Lone-Jade/ZYNQ7020-QR_Code_Recogition/skill/camera-hdmi-diagnosis/references/provenance.md

# Scope and verification limits

Camera source/control, pixel formats and geometry, memory transfer, processing and physical display diagnosis.

Configuration reads, refreshing counters and stored frame dumps establish different boundaries. Live frame integrity and physical output require observations from the actual system.

Use the checks appropriate to the requested change and report which were actually executed. Package contents are reusable procedures and helpers; they do not certify a new environment or target.
