Lone-Jade/ZYNQ7020-QR_Code_Recogition/src/hardware/pynq_ax7021b/hardware/desktop/README.md

# R4 HDMI硬件源文件

当前使用R4 PL彩色直显和绿色叠加。统一构建、启动和部署方式见项目根目录[README](../../../../../README.md)。本目录保留设计源文件，不提供旧桌面系统启动入口。
