Lone-Jade/ZYNQ7020-QR_Code_Recogition/src/hardware/pynq_ax7021b/hardware/qr_desktop/roi_selection/README.md

# R4 ROI 硬件源文件

保留实际使用的RTL和post-route脚本。统一构建入口见项目根README：build/scripts/hardware.py；旧A/B工具和PWM演示未进入最终包。
