Lone-Jade/ZYNQ7020-QR_Code_Recogition/skill/algorithm-porting-and-replay/references/provenance.md

# Scope and verification limits

Processing-code migration, numeric and semantic comparison, frozen-input regression and reproducible failure replay.

The supplied helpers inspect their documented input formats. Same-input equivalence does not qualify camera acquisition, physical I/O or target throughput.

Use the checks appropriate to the requested change and report which were actually executed. Package contents are reusable procedures and helpers; they do not certify a new environment or target.
