Lone-Jade/ZYNQ7020-QR_Code_Recogition/skill/hardware-build-and-handoff/references/provenance.md

# Scope and verification limits

Hardware-dependent build chains, interface matching, artifact qualification and reproducible delivery.

File hashes and metadata checks establish identity. Timing, ABI compatibility, boot success and runtime behavior require the corresponding tool or target checks.

Use the checks appropriate to the requested change and report which were actually executed. Package contents are reusable procedures and helpers; they do not certify a new environment or target.
