Lone-Jade/ZYNQ7020-QR_Code_Recogition/board/results/INTERFACES.md

# 运行与显示接口

PS 二维码公开结果结构为 8392 字节。`qr_mainline_get_symbol_geometry` 按最近一次成功结果的符号索引，返回解码源 epoch/frame、四个绝对坐标角点和对应 PL ROI。相同内容、不同空间位置的二维码保留独立发布身份。

显示 ABI 2 使用 ioctl D/5，结构大小 912 字节：16 字节头、128 字节 ASCII 状态区和 8 个 96 字节标注。显示驱动检查坐标、epoch、序号、标签和 pending 银行所有权。硬件 version=2、capabilities=11，场景能力位为 bit 8。

AXI-Lite `0x200..0x27c` 保存非活动场景描述符，`0x1000..0x13fc` 保存非活动字符 RAM。`0x20` 提交场景序号，`0x24` 返回确认。垂直消隐期同步切换框、标签与状态文字；pending 银行在确认前不可修改。连续 180 个输出帧无更新时图层过期。

PL 彩色预览独立于解码运行。停止识别会清除框和标签；完整停止由 `sudo zynq-qr stop` 管理。PS 最多显示 8 个目标，标签最多 9 个 ASCII 字符，并检查标签与所属框的相对位置、画面边界、状态区与其他标签的遮挡。

参考运行包仅显示来自成功解码的四角坐标，过期、乱序、epoch 不一致或关联不明确的标注会被隐藏。实际移动框覆盖率与摄像头到显示的延迟需通过明确的光学测试单独测量。
