Lone-Jade/ZYNQ7020-QR_Code_Recogition/build/reports/measured-final-v1/timing_summary.txt

Copyright 1986-2022 Xilinx, Inc. All Rights Reserved. Copyright 2022-2025 Advanced Micro Devices, Inc. All Rights Reserved.
-------------------------------------------------------------------------------------------------------------------------------------------------------------------------------
| Tool Version : Vivado v.2025.2 (lin64) Build 6299465 Fri Nov 14 12:34:56 MST 2025
| Date         : Sun Oct 25 19:09:49 2026
| Host         : build-host running 64-bit Ubuntu 22.04.5 LTS
| Command      : report_timing_summary -file /home/builder/FPGA_Competition/linux_bringup/development/C04-R4-FINALIZE/build/final-v1/ax7021b_linux_qr_desktop/timing_summary.txt
| Design       : qr_desktop_top
| Device       : 7z020-clg484
| Speed File   : -2  PRODUCTION 1.12 2019-11-22
| Design State : Routed
-------------------------------------------------------------------------------------------------------------------------------------------------------------------------------

Timing Summary Report

------------------------------------------------------------------------------------------------
| Timer Settings
| --------------
------------------------------------------------------------------------------------------------

  Enable Multi Corner Analysis               :  Yes
  Enable Pessimism Removal                   :  Yes
  Pessimism Removal Resolution               :  Nearest Common Node
  Enable Input Delay Default Clock           :  No
  Enable Preset / Clear Arcs                 :  No
  Disable Flight Delays                      :  No
  Ignore I/O Paths                           :  No
  Timing Early Launch at Borrowing Latches   :  No
  Borrow Time for Max Delay Exceptions       :  Yes
  Merge Timing Exceptions                    :  Yes
  Inter-SLR Compensation                     :  Conservative

  Corner  Analyze    Analyze    
  Name    Max Paths  Min Paths  
  ------  ---------  ---------  
  Slow    Yes        Yes        
  Fast    Yes        Yes        

------------------------------------------------------------------------------------------------
| Report Methodology
| ------------------
------------------------------------------------------------------------------------------------

Rule       Severity          Description                                                Violations  
---------  ----------------  ---------------------------------------------------------  ----------  
TIMING-4   Critical Warning  Invalid primary clock redefinition on a clock tree         1           
TIMING-27  Critical Warning  Invalid primary clock on hierarchical pin                  1           
LUTAR-1    Warning           LUT drives async reset alert                               8           
SYNTH-5    Warning           Mapped onto distributed RAM because of timing constraints  16          
SYNTH-6    Warning           Timing of a RAM block might be sub-optimal                 6           
TIMING-10  Warning           Missing property on synchronizer                           1           
TIMING-18  Warning           Missing input or output delay                              22          
ULMTCS-1   Warning           Control Sets use limits recommend reduction                1           
XDCB-5     Warning           Runtime inefficient way to find pin objects                1           

Note: This report is based on the most recent report_methodology run and may not be up-to-date. Run report_methodology on the current design for the latest report.

check_timing report

Table of Contents
-----------------
1. checking no_clock (0)
2. checking constant_clock (0)
3. checking pulse_width_clock (0)
4. checking unconstrained_internal_endpoints (0)
5. checking no_input_delay (14)
6. checking no_output_delay (7)
7. checking multiple_clock (0)
8. checking generated_clocks (0)
9. checking loops (0)
10. checking partial_input_delay (0)
11. checking partial_output_delay (0)
12. checking latch_loops (0)

1. checking no_clock (0)
------------------------
 There are 0 register/latch pins with no clock.

2. checking constant_clock (0)
------------------------------
 There are 0 register/latch pins with constant_clock.

3. checking pulse_width_clock (0)
---------------------------------
 There are 0 register/latch pins which need pulse_width check

4. checking unconstrained_internal_endpoints (0)
------------------------------------------------
 There are 0 pins that are not constrained for maximum delay.

 There are 0 pins that are not constrained for maximum delay due to constant clock.

5. checking no_input_delay (14)
-------------------------------
 There are 14 input ports with no input delay specified. (HIGH)

 There are 0 input ports with no input delay but user has a false path constraint.

6. checking no_output_delay (7)
-------------------------------
 There are 6 ports with no output delay specified. (HIGH)

 There are 0 ports with no output delay but user has a false path constraint

 There is 1 port with no output delay but with a timing clock defined on it or propagating through it (LOW)

7. checking multiple_clock (0)
------------------------------
 There are 0 register/latch pins with multiple clocks.

8. checking generated_clocks (0)
--------------------------------
 There are 0 generated clocks that are not connected to a clock source.

9. checking loops (0)
---------------------
 There are 0 combinational loops in the design.

10. checking partial_input_delay (0)
------------------------------------
 There are 0 input ports with partial input delay specified.

11. checking partial_output_delay (0)
-------------------------------------
 There are 0 ports with partial output delay specified.

12. checking latch_loops (0)
----------------------------
 There are 0 combinational latch loops in the design through latch input

------------------------------------------------------------------------------------------------
| Design Timing Summary
| ---------------------
------------------------------------------------------------------------------------------------

    WNS(ns)      TNS(ns)  TNS Failing Endpoints  TNS Total Endpoints      WHS(ns)      THS(ns)  THS Failing Endpoints  THS Total Endpoints     WPWS(ns)     TPWS(ns)  TPWS Failing Endpoints  TPWS Total Endpoints  
    -------      -------  ---------------------  -------------------      -------      -------  ---------------------  -------------------     --------     --------  ----------------------  --------------------  
      0.072        0.000                      0               142984        0.042        0.000                      0               142508        3.000        0.000                       0                 51697  

All user specified timing constraints are met.

------------------------------------------------------------------------------------------------
| Clock Summary
| -------------
------------------------------------------------------------------------------------------------

Clock                                       Waveform(ns)         Period(ns)      Frequency(MHz)
-----                                       ------------         ----------      --------------
cam1_pclk                                   {0.000 4.850}        9.700           103.093         
clk_fpga_0                                  {0.000 5.000}        10.000          100.000         
clk_fpga_1                                  {0.000 6.499}        12.999          76.929          
system_i/system_i/pixel_clock/inst/clk_in1  {0.000 5.000}        10.000          100.000         
  clk_out1_system_pixel_clock_0             {0.000 6.734}        13.468          74.250          
    hdmi_forwarded                          {6.734 13.468}       13.468          74.250          
  clkfbout_system_pixel_clock_0             {0.000 20.000}       40.000          25.000          

------------------------------------------------------------------------------------------------
| Intra Clock Table
| -----------------
------------------------------------------------------------------------------------------------

Clock                                           WNS(ns)      TNS(ns)  TNS Failing Endpoints  TNS Total Endpoints      WHS(ns)      THS(ns)  THS Failing Endpoints  THS Total Endpoints     WPWS(ns)     TPWS(ns)  TPWS Failing Endpoints  TPWS Total Endpoints  
-----                                           -------      -------  ---------------------  -------------------      -------      -------  ---------------------  -------------------     --------     --------  ----------------------  --------------------  
cam1_pclk                                         1.907        0.000                      0                 7091        0.076        0.000                      0                 7091        3.720        0.000                       0                  1461  
clk_fpga_0                                        0.401        0.000                      0                60391        0.042        0.000                      0                60391        3.870        0.000                       0                 28310  
clk_fpga_1                                        0.072        0.000                      0                72091        0.044        0.000                      0                72091        5.369        0.000                       0                 20877  
system_i/system_i/pixel_clock/inst/clk_in1                                                                                                                                                    3.000        0.000                       0                     1  
  clk_out1_system_pixel_clock_0                   2.126        0.000                      0                 2686        0.108        0.000                      0                 2686        5.880        0.000                       0                  1045  
  clkfbout_system_pixel_clock_0                                                                                                                                                              38.408        0.000                       0                     3  

------------------------------------------------------------------------------------------------
| Inter Clock Table
| -----------------
------------------------------------------------------------------------------------------------

From Clock                     To Clock                           WNS(ns)      TNS(ns)  TNS Failing Endpoints  TNS Total Endpoints      WHS(ns)      THS(ns)  THS Failing Endpoints  THS Total Endpoints  
----------                     --------                           -------      -------  ---------------------  -------------------      -------      -------  ---------------------  -------------------  
clk_fpga_0                     cam1_pclk                            7.871        0.000                      0                   40                                                                        
clk_fpga_1                     cam1_pclk                           11.714        0.000                      0                    5                                                                        
cam1_pclk                      clk_fpga_0                           6.760        0.000                      0                  219                                                                        
clk_fpga_1                     clk_fpga_0                          10.499        0.000                      0                   79                                                                        
clk_out1_system_pixel_clock_0  clk_fpga_0                           7.666        0.000                      0                  135                                                                        
cam1_pclk                      clk_fpga_1                           6.364        0.000                      0                   89                                                                        
clk_fpga_0                     clk_fpga_1                           8.691        0.000                      0                   73                                                                        
cam1_pclk                      clk_out1_system_pixel_clock_0        7.865        0.000                      0                    1                                                                        
clk_fpga_0                     clk_out1_system_pixel_clock_0        6.564        0.000                      0                  554                                                                        
clk_out1_system_pixel_clock_0  hdmi_forwarded                       0.405        0.000                      0                   27        6.184        0.000                      0                   27  

------------------------------------------------------------------------------------------------
| Other Path Groups Table
| -----------------------
------------------------------------------------------------------------------------------------

Path Group         From Clock         To Clock               WNS(ns)      TNS(ns)  TNS Failing Endpoints  TNS Total Endpoints      WHS(ns)      THS(ns)  THS Failing Endpoints  THS Total Endpoints  
----------         ----------         --------               -------      -------  ---------------------  -------------------      -------      -------  ---------------------  -------------------  
**async_default**  cam1_pclk          cam1_pclk                4.892        0.000                      0                   30        0.678        0.000                      0                   30  
**async_default**  clk_fpga_0         clk_fpga_0               5.903        0.000                      0                  192        0.598        0.000                      0                  192  

------------------------------------------------------------------------------------------------
| Timing Details
| --------------
------------------------------------------------------------------------------------------------

---------------------------------------------------------------------------------------------------
From Clock:  cam1_pclk
  To Clock:  cam1_pclk

Setup :            0  Failing Endpoints,  Worst Slack        1.907ns,  Total Violation        0.000ns
Hold  :            0  Failing Endpoints,  Worst Slack        0.076ns,  Total Violation        0.000ns
PW    :            0  Failing Endpoints,  Worst Slack        3.720ns,  Total Violation        0.000ns
---------------------------------------------------------------------------------------------------

Max Delay Paths
--------------------------------------------------------------------------------------
Slack (MET) :             1.907ns  (required time - arrival time)
  Source:                 capture_i/read_pointer_reg[1]_rep__1/C
                            (rising edge-triggered cell FDRE clocked by cam1_pclk  {rise@0.000ns fall@4.850ns period=9.700ns})
  Destination:            fork_i/display/memory_reg_0/ENARDEN
                            (rising edge-triggered cell RAMB36E1 clocked by cam1_pclk  {rise@0.000ns fall@4.850ns period=9.700ns})
  Path Group:             cam1_pclk
  Path Type:              Setup (Max at Slow Process Corner)
  Requirement:            9.700ns  (cam1_pclk rise@9.700ns - cam1_pclk rise@0.000ns)
  Data Path Delay:        7.145ns  (logic 1.733ns (24.255%)  route 5.412ns (75.745%))
  Logic Levels:           7  (LUT2=1 LUT3=1 LUT6=2 MUXF7=2 RAMD64E=1)
  Clock Path Skew:        -0.056ns (DCD - SCD + CPR)
    Destination Clock Delay (DCD):    4.691ns = ( 14.391 - 9.700 ) 
    Source Clock Delay      (SCD):    5.145ns
    Clock Pessimism Removal (CPR):    0.399ns
  Clock Uncertainty:      0.035ns  ((TSJ^2 + TIJ^2)^1/2 + DJ) / 2 + PE
    Total System Jitter     (TSJ):    0.071ns
    Total Input Jitter      (TIJ):    0.000ns
    Discrete Jitter          (DJ):    0.000ns
    Phase Error              (PE):    0.000ns

    Location             Delay type                Incr(ns)  Path(ns)    Netlist Resource(s)
  -------------------------------------------------------------------    -------------------
                         (clock cam1_pclk rise edge)
                                                      0.000     0.000 r  
    AB9                                               0.000     0.000 r  cam1_pclk (IN)
                         net (fo=0)                   0.000     0.000    cam1_pclk
    AB9                  IBUF (Prop_ibuf_I_O)         1.448     1.448 r  cam1_pclk_IBUF_inst/O
                         net (fo=1, routed)           2.207     3.655    cam1_pclk_IBUF
    BUFGCTRL_X0Y1        BUFG (Prop_bufg_I_O)         0.085     3.740 r  cam1_pclk_IBUF_BUFG_inst/O
                         net (fo=1460, routed)        1.405     5.145    capture_i/cam1_pclk_IBUF_BUFG
    SLICE_X45Y43         FDRE                                         r  capture_i/read_pointer_reg[1]_rep__1/C
  -------------------------------------------------------------------    -------------------
    SLICE_X45Y43         FDRE (Prop_fdre_C_Q)         0.379     5.524 r  capture_i/read_pointer_reg[1]_rep__1/Q
                         net (fo=85, routed)          1.136     6.660    capture_i/fifo_user_reg_768_895_0_0/DPRA1
    SLICE_X34Y40         RAMD64E (Prop_ramd64e_RADR1_O)
                                                      0.105     6.765 r  capture_i/fifo_user_reg_768_895_0_0/DP.HIGH/O
                         net (fo=1, routed)           0.000     6.765    capture_i/fifo_user_reg_768_895_0_0/DPO1
    SLICE_X34Y40         MUXF7 (Prop_muxf7_I1_O)      0.178     6.943 r  capture_i/fifo_user_reg_768_895_0_0/F7.DP/O
                         net (fo=1, routed)           0.760     7.703    capture_i/fifo_user_reg_768_895_0_0_n_0
    SLICE_X37Y42         LUT6 (Prop_lut6_I1_O)        0.241     7.944 r  capture_i/memory_reg_0_i_41/O
                         net (fo=1, routed)           0.000     7.944    capture_i/memory_reg_0_i_41_n_0
    SLICE_X37Y42         MUXF7 (Prop_muxf7_I1_O)      0.182     8.126 r  capture_i/memory_reg_0_i_16/O
                         net (fo=13, routed)          0.875     9.001    capture_i/capture_user
    SLICE_X43Y51         LUT2 (Prop_lut2_I0_O)        0.255     9.256 r  capture_i/system_i_i_2/O
                         net (fo=49, routed)          0.837    10.093    fork_i/display/diag_source_sof0
    SLICE_X48Y54         LUT6 (Prop_lut6_I5_O)        0.267    10.360 f  fork_i/display/memory_reg_0_i_36/O
                         net (fo=13, routed)          1.049    11.409    fork_i/display/memory_reg_0_i_36_n_0
    SLICE_X47Y49         LUT3 (Prop_lut3_I0_O)        0.126    11.535 r  fork_i/display/memory_reg_0_i_1/O
                         net (fo=2, routed)           0.756    12.290    fork_i/display/p_15_in
    RAMB36_X3Y9          RAMB36E1                                     r  fork_i/display/memory_reg_0/ENARDEN
  -------------------------------------------------------------------    -------------------

                         (clock cam1_pclk rise edge)
                                                      9.700     9.700 r  
    AB9                                               0.000     9.700 r  cam1_pclk (IN)
                         net (fo=0)                   0.000     9.700    cam1_pclk
    AB9                  IBUF (Prop_ibuf_I_O)         1.382    11.082 r  cam1_pclk_IBUF_inst/O
                         net (fo=1, routed)           1.894    12.976    cam1_pclk_IBUF
    BUFGCTRL_X0Y1        BUFG (Prop_bufg_I_O)         0.077    13.053 r  cam1_pclk_IBUF_BUFG_inst/O
                         net (fo=1460, routed)        1.337    14.391    fork_i/display/cam1_pclk_IBUF_BUFG
    RAMB36_X3Y9          RAMB36E1                                     r  fork_i/display/memory_reg_0/CLKARDCLK
                         clock pessimism              0.399    14.790    
                         clock uncertainty           -0.035    14.754    
    RAMB36_X3Y9          RAMB36E1 (Setup_ramb36e1_CLKARDCLK_ENARDEN)
                                                     -0.557    14.197    fork_i/display/memory_reg_0
  -------------------------------------------------------------------
                         required time                         14.197    
                         arrival time                         -12.290    
  -------------------------------------------------------------------
                         slack                                  1.907    

Min Delay Paths
--------------------------------------------------------------------------------------
Slack (MET) :             0.076ns  (arrival time - required time)
  Source:                 fork_i/display/wr_reg[5]/C
                            (rising edge-triggered cell FDRE clocked by cam1_pclk  {rise@0.000ns fall@4.850ns period=9.700ns})
  Destination:            fork_i/display/memory_reg_1/ADDRARDADDR[10]
                            (rising edge-triggered cell RAMB36E1 clocked by cam1_pclk  {rise@0.000ns fall@4.850ns period=9.700ns})
  Path Group:             cam1_pclk
  Path Type:              Hold (Min at Fast Process Corner)
  Requirement:            0.000ns  (cam1_pclk rise@0.000ns - cam1_pclk rise@0.000ns)
  Data Path Delay:        0.563ns  (logic 0.141ns (25.050%)  route 0.422ns (74.950%))
  Logic Levels:           0  
  Clock Path Skew:        0.304ns (DCD - SCD - CPR)
    Destination Clock Delay (DCD):    2.683ns
    Source Clock Delay      (SCD):    2.018ns
    Clock Pessimism Removal (CPR):    0.360ns

    Location             Delay type                Incr(ns)  Path(ns)    Netlist Resource(s)
  -------------------------------------------------------------------    -------------------
                         (clock cam1_pclk rise edge)
                                                      0.000     0.000 r  
    AB9                                               0.000     0.000 r  cam1_pclk (IN)
                         net (fo=0)                   0.000     0.000    cam1_pclk
    AB9                  IBUF (Prop_ibuf_I_O)         0.285     0.285 r  cam1_pclk_IBUF_inst/O
                         net (fo=1, routed)           1.126     1.411    cam1_pclk_IBUF
    BUFGCTRL_X0Y1        BUFG (Prop_bufg_I_O)         0.026     1.437 r  cam1_pclk_IBUF_BUFG_inst/O
                         net (fo=1460, routed)        0.582     2.018    fork_i/display/cam1_pclk_IBUF_BUFG
    SLICE_X56Y49         FDRE                                         r  fork_i/display/wr_reg[5]/C
  -------------------------------------------------------------------    -------------------
    SLICE_X56Y49         FDRE (Prop_fdre_C_Q)         0.141     2.159 r  fork_i/display/wr_reg[5]/Q
                         net (fo=5, routed)           0.422     2.581    fork_i/display/wr_reg[5]
    RAMB36_X3Y10         RAMB36E1                                     r  fork_i/display/memory_reg_1/ADDRARDADDR[10]
  -------------------------------------------------------------------    -------------------

                         (clock cam1_pclk rise edge)
                                                      0.000     0.000 r  
    AB9                                               0.000     0.000 r  cam1_pclk (IN)
                         net (fo=0)                   0.000     0.000    cam1_pclk
    AB9                  IBUF (Prop_ibuf_I_O)         0.473     0.473 r  cam1_pclk_IBUF_inst/O
                         net (fo=1, routed)           1.295     1.768    cam1_pclk_IBUF
    BUFGCTRL_X0Y1        BUFG (Prop_bufg_I_O)         0.029     1.797 r  cam1_pclk_IBUF_BUFG_inst/O
                         net (fo=1460, routed)        0.886     2.683    fork_i/display/cam1_pclk_IBUF_BUFG
    RAMB36_X3Y10         RAMB36E1                                     r  fork_i/display/memory_reg_1/CLKARDCLK
                         clock pessimism             -0.360     2.323    
    RAMB36_X3Y10         RAMB36E1 (Hold_ramb36e1_CLKARDCLK_ADDRARDADDR[10])
                                                      0.183     2.506    fork_i/display/memory_reg_1
  -------------------------------------------------------------------
                         required time                         -2.506    
                         arrival time                           2.581    
  -------------------------------------------------------------------
                         slack                                  0.076    

Pulse Width Checks
--------------------------------------------------------------------------------------
Clock Name:         cam1_pclk
Waveform(ns):       { 0.000 4.850 }
Period(ns):         9.700
Sources:            { cam1_pclk }

Check Type        Corner  Lib Pin             Reference Pin  Required(ns)  Actual(ns)  Slack(ns)  Location      Pin
Min Period        n/a     RAMB36E1/CLKARDCLK  n/a            2.472         9.700       7.228      RAMB36_X3Y9   fork_i/display/memory_reg_0/CLKARDCLK
Low Pulse Width   Slow    RAMD64E/CLK         n/a            1.130         4.850       3.720      SLICE_X58Y49  capture_i/fifo_data_reg_0_63_0_2/RAMA/CLK
High Pulse Width  Slow    RAMD64E/CLK         n/a            1.130         4.850       3.720      SLICE_X58Y49  capture_i/fifo_data_reg_0_63_0_2/RAMA/CLK

---------------------------------------------------------------------------------------------------
From Clock:  clk_fpga_0
  To Clock:  clk_fpga_0

Setup :            0  Failing Endpoints,  Worst Slack        0.401ns,  Total Violation        0.000ns
Hold  :            0  Failing Endpoints,  Worst Slack        0.042ns,  Total Violation        0.000ns
PW    :            0  Failing Endpoints,  Worst Slack        3.870ns,  Total Violation        0.000ns
---------------------------------------------------------------------------------------------------

Max Delay Paths
--------------------------------------------------------------------------------------
Slack (MET) :             0.401ns  (required time - arrival time)
  Source:                 system_i/system_i/ps7/inst/PS7_i/MAXIGP0ACLK
                            (rising edge-triggered cell PS7 clocked by clk_fpga_0  {rise@0.000ns fall@5.000ns period=10.000ns})
  Destination:            system_i/system_i/display_osd/inst/wstrb_reg[3]/D
                            (rising edge-triggered cell FDRE clocked by clk_fpga_0  {rise@0.000ns fall@5.000ns period=10.000ns})
  Path Group:             clk_fpga_0
  Path Type:              Setup (Max at Slow Process Corner)
  Requirement:            10.000ns  (clk_fpga_0 rise@10.000ns - clk_fpga_0 rise@0.000ns)
  Data Path Delay:        9.206ns  (logic 1.108ns (12.036%)  route 8.098ns (87.964%))
  Logic Levels:           0  
  Clock Path Skew:        -0.212ns (DCD - SCD + CPR)
    Destination Clock Delay (DCD):    2.234ns = ( 12.234 - 10.000 ) 
    Source Clock Delay      (SCD):    2.542ns
    Clock Pessimism Removal (CPR):    0.097ns
  Clock Uncertainty:      0.154ns  ((TSJ^2 + TIJ^2)^1/2 + DJ) / 2 + PE
    Total System Jitter     (TSJ):    0.071ns
    Total Input Jitter      (TIJ):    0.300ns
    Discrete Jitter          (DJ):    0.000ns
    Phase Error              (PE):    0.000ns

    Location             Delay type                Incr(ns)  Path(ns)    Netlist Resource(s)
  -------------------------------------------------------------------    -------------------
                         (clock clk_fpga_0 rise edge)
                                                      0.000     0.000 r  
    PS7_X0Y0             PS7                          0.000     0.000 r  system_i/system_i/ps7/inst/PS7_i/FCLKCLK[0]
                         net (fo=1, routed)           0.994     0.994    system_i/system_i/ps7/inst/FCLK_CLK_unbuffered[0]
    BUFGCTRL_X0Y16       BUFG (Prop_bufg_I_O)         0.085     1.079 r  system_i/system_i/ps7/inst/buffer_fclk_clk_0.FCLK_CLK_0_BUFG/O
                         net (fo=28349, routed)       1.463     2.542    system_i/system_i/ps7/inst/M_AXI_GP0_ACLK
    PS7_X0Y0             PS7                                          r  system_i/system_i/ps7/inst/PS7_i/MAXIGP0ACLK
  -------------------------------------------------------------------    -------------------
    PS7_X0Y0             PS7 (Prop_ps7_MAXIGP0ACLK_MAXIGP0WSTRB[3])
                                                      1.108     3.650 r  system_i/system_i/ps7/inst/PS7_i/MAXIGP0WSTRB[3]
                         net (fo=251, routed)         8.098    11.748    system_i/system_i/display_osd/inst/s_axi_wstrb[3]
    SLICE_X44Y47         FDRE                                         r  system_i/system_i/display_osd/inst/wstrb_reg[3]/D
  -------------------------------------------------------------------    -------------------

                         (clock clk_fpga_0 rise edge)
                                                     10.000    10.000 r  
    PS7_X0Y0             PS7                          0.000    10.000 r  system_i/system_i/ps7/inst/PS7_i/FCLKCLK[0]
                         net (fo=1, routed)           0.905    10.906    system_i/system_i/ps7/inst/FCLK_CLK_unbuffered[0]
    BUFGCTRL_X0Y16       BUFG (Prop_bufg_I_O)         0.077    10.983 r  system_i/system_i/ps7/inst/buffer_fclk_clk_0.FCLK_CLK_0_BUFG/O
                         net (fo=28349, routed)       1.252    12.234    system_i/system_i/display_osd/inst/aclk
    SLICE_X44Y47         FDRE                                         r  system_i/system_i/display_osd/inst/wstrb_reg[3]/C
                         clock pessimism              0.097    12.331    
                         clock uncertainty           -0.154    12.177    
    SLICE_X44Y47         FDRE (Setup_fdre_C_D)       -0.027    12.150    system_i/system_i/display_osd/inst/wstrb_reg[3]
  -------------------------------------------------------------------
                         required time                         12.150    
                         arrival time                         -11.748    
  -------------------------------------------------------------------
                         slack                                  0.401    

Min Delay Paths
--------------------------------------------------------------------------------------
Slack (MET) :             0.042ns  (arrival time - required time)
  Source:                 system_i/system_i/display_camera_cdc/inst/gen_async_conv.axisc_async_clock_converter_0/xpm_fifo_async_inst/gnuram_async_fifo.xpm_fifo_base_inst/gen_sdpram.xpm_memory_base_inst/gen_rd_b.gen_rd_b_synth_template.gen_rf_narrow_pipe.doutb_reg_reg[62]/C
                            (rising edge-triggered cell FDRE clocked by clk_fpga_0  {rise@0.000ns fall@5.000ns period=10.000ns})
  Destination:            system_i/system_i/display_camera_cdc/inst/gen_async_conv.axisc_async_clock_converter_0/xpm_fifo_async_inst/gnuram_async_fifo.xpm_fifo_base_inst/gen_sdpram.xpm_memory_base_inst/gen_rd_b.gen_doutb_pipe.gen_stage.doutb_pipe_reg[0][62]/D
                            (rising edge-triggered cell FDRE clocked by clk_fpga_0  {rise@0.000ns fall@5.000ns period=10.000ns})
  Path Group:             clk_fpga_0
  Path Type:              Hold (Min at Fast Process Corner)
  Requirement:            0.000ns  (clk_fpga_0 rise@0.000ns - clk_fpga_0 rise@0.000ns)
  Data Path Delay:        0.328ns  (logic 0.128ns (39.056%)  route 0.200ns (60.944%))
  Logic Levels:           0  
  Clock Path Skew:        0.262ns (DCD - SCD - CPR)
    Destination Clock Delay (DCD):    1.187ns
    Source Clock Delay      (SCD):    0.895ns
    Clock Pessimism Removal (CPR):    0.030ns

    Location             Delay type                Incr(ns)  Path(ns)    Netlist Resource(s)
  -------------------------------------------------------------------    -------------------
                         (clock clk_fpga_0 rise edge)
                                                      0.000     0.000 r  
    PS7_X0Y0             PS7                          0.000     0.000 r  system_i/system_i/ps7/inst/PS7_i/FCLKCLK[0]
                         net (fo=1, routed)           0.310     0.310    system_i/system_i/ps7/inst/FCLK_CLK_unbuffered[0]
    BUFGCTRL_X0Y16       BUFG (Prop_bufg_I_O)         0.026     0.336 r  system_i/system_i/ps7/inst/buffer_fclk_clk_0.FCLK_CLK_0_BUFG/O
                         net (fo=28349, routed)       0.559     0.895    system_i/system_i/display_camera_cdc/inst/gen_async_conv.axisc_async_clock_converter_0/xpm_fifo_async_inst/gnuram_async_fifo.xpm_fifo_base_inst/gen_sdpram.xpm_memory_base_inst/clkb
    SLICE_X52Y49         FDRE                                         r  system_i/system_i/display_camera_cdc/inst/gen_async_conv.axisc_async_clock_converter_0/xpm_fifo_async_inst/gnuram_async_fifo.xpm_fifo_base_inst/gen_sdpram.xpm_memory_base_inst/gen_rd_b.gen_rd_b_synth_template.gen_rf_narrow_pipe.doutb_reg_reg[62]/C
  -------------------------------------------------------------------    -------------------
    SLICE_X52Y49         FDRE (Prop_fdre_C_Q)         0.128     1.023 r  system_i/system_i/display_camera_cdc/inst/gen_async_conv.axisc_async_clock_converter_0/xpm_fifo_async_inst/gnuram_async_fifo.xpm_fifo_base_inst/gen_sdpram.xpm_memory_base_inst/gen_rd_b.gen_rd_b_synth_template.gen_rf_narrow_pipe.doutb_reg_reg[62]/Q
                         net (fo=1, routed)           0.200     1.222    system_i/system_i/display_camera_cdc/inst/gen_async_conv.axisc_async_clock_converter_0/xpm_fifo_async_inst/gnuram_async_fifo.xpm_fifo_base_inst/gen_sdpram.xpm_memory_base_inst/gen_rd_b.gen_rd_b_synth_template.gen_rf_narrow_pipe.doutb_reg_reg[62]
    SLICE_X52Y50         FDRE                                         r  system_i/system_i/display_camera_cdc/inst/gen_async_conv.axisc_async_clock_converter_0/xpm_fifo_async_inst/gnuram_async_fifo.xpm_fifo_base_inst/gen_sdpram.xpm_memory_base_inst/gen_rd_b.gen_doutb_pipe.gen_stage.doutb_pipe_reg[0][62]/D
  -------------------------------------------------------------------    -------------------

                         (clock clk_fpga_0 rise edge)
                                                      0.000     0.000 r  
    PS7_X0Y0             PS7                          0.000     0.000 r  system_i/system_i/ps7/inst/PS7_i/FCLKCLK[0]
                         net (fo=1, routed)           0.337     0.337    system_i/system_i/ps7/inst/FCLK_CLK_unbuffered[0]
    BUFGCTRL_X0Y16       BUFG (Prop_bufg_I_O)         0.029     0.366 r  system_i/system_i/ps7/inst/buffer_fclk_clk_0.FCLK_CLK_0_BUFG/O
                         net (fo=28349, routed)       0.821     1.187    system_i/system_i/display_camera_cdc/inst/gen_async_conv.axisc_async_clock_converter_0/xpm_fifo_async_inst/gnuram_async_fifo.xpm_fifo_base_inst/gen_sdpram.xpm_memory_base_inst/clkb
    SLICE_X52Y50         FDRE                                         r  system_i/system_i/display_camera_cdc/inst/gen_async_conv.axisc_async_clock_converter_0/xpm_fifo_async_inst/gnuram_async_fifo.xpm_fifo_base_inst/gen_sdpram.xpm_memory_base_inst/gen_rd_b.gen_doutb_pipe.gen_stage.doutb_pipe_reg[0][62]/C
                         clock pessimism             -0.030     1.157    
    SLICE_X52Y50         FDRE (Hold_fdre_C_D)         0.023     1.180    system_i/system_i/display_camera_cdc/inst/gen_async_conv.axisc_async_clock_converter_0/xpm_fifo_async_inst/gnuram_async_fifo.xpm_fifo_base_inst/gen_sdpram.xpm_memory_base_inst/gen_rd_b.gen_doutb_pipe.gen_stage.doutb_pipe_reg[0][62]
  -------------------------------------------------------------------
                         required time                         -1.180    
                         arrival time                           1.222    
  -------------------------------------------------------------------
                         slack                                  0.042    

Pulse Width Checks
--------------------------------------------------------------------------------------
Clock Name:         clk_fpga_0
Waveform(ns):       { 0.000 5.000 }
Period(ns):         10.000
Sources:            { system_i/system_i/ps7/inst/PS7_i/FCLKCLK[0] }

Check Type        Corner  Lib Pin      Reference Pin  Required(ns)  Actual(ns)  Slack(ns)  Location      Pin
Min Period        n/a     DSP48E1/CLK  n/a            3.602         10.000      6.398      DSP48_X4Y34   qr_desktop_top/system_wrapper/system/system_fitness_0/system_fitness_0_qr_fitness/system_fitness_0_qr_fitness_qr_fitness_Pipeline_VITIS_LOOP_35_1_VITIS_LOOP_40_2/system_fitness_0_qr_fitness_dmul_64ns_64ns_64_6_max_dsp_1__xdcDup__1/system_fitness_0_qr_fitness_dmul_64ns_64ns_64_6_max_dsp_1_ip__6/<hidden>/<hidden>/<hidden>/<hidden>/<hidden>/<hidden>
Low Pulse Width   Slow    RAMD32/CLK   n/a            1.130         5.000       3.870      SLICE_X46Y58  system_i/system_i/display_guard/inst/response_fifo_reg_0_15_0_2/RAMA/CLK
High Pulse Width  Slow    RAMD32/CLK   n/a            1.130         5.000       3.870      SLICE_X46Y58  system_i/system_i/display_guard/inst/response_fifo_reg_0_15_0_2/RAMA/CLK

---------------------------------------------------------------------------------------------------
From Clock:  clk_fpga_1
  To Clock:  clk_fpga_1

Setup :            0  Failing Endpoints,  Worst Slack        0.072ns,  Total Violation        0.000ns
Hold  :            0  Failing Endpoints,  Worst Slack        0.044ns,  Total Violation        0.000ns
PW    :            0  Failing Endpoints,  Worst Slack        5.369ns,  Total Violation        0.000ns
---------------------------------------------------------------------------------------------------

Max Delay Paths
--------------------------------------------------------------------------------------
Slack (MET) :             0.072ns  (required time - arrival time)
  Source:                 system_i/system_i/qr_preprocess_0/inst/pl_roi.pipeline/geometry/c1_reg[2]/C
                            (rising edge-triggered cell FDRE clocked by clk_fpga_1  {rise@0.000ns fall@6.499ns period=12.999ns})
  Destination:            system_i/system_i/qr_preprocess_0/inst/pl_roi.pipeline/geometry/pending_flags_reg[0]/D
                            (rising edge-triggered cell FDRE clocked by clk_fpga_1  {rise@0.000ns fall@6.499ns period=12.999ns})
  Path Group:             clk_fpga_1
  Path Type:              Setup (Max at Slow Process Corner)
  Requirement:            12.999ns  (clk_fpga_1 rise@12.999ns - clk_fpga_1 rise@0.000ns)
  Data Path Delay:        12.702ns  (logic 4.928ns (38.796%)  route 7.774ns (61.204%))
  Logic Levels:           23  (CARRY4=14 LUT2=1 LUT3=1 LUT4=3 LUT5=3 LUT6=1)
  Clock Path Skew:        -0.058ns (DCD - SCD + CPR)
    Destination Clock Delay (DCD):    2.280ns = ( 15.279 - 12.999 ) 
    Source Clock Delay      (SCD):    2.531ns
    Clock Pessimism Removal (CPR):    0.193ns
  Clock Uncertainty:      0.198ns  ((TSJ^2 + TIJ^2)^1/2 + DJ) / 2 + PE
    Total System Jitter     (TSJ):    0.071ns
    Total Input Jitter      (TIJ):    0.390ns
    Discrete Jitter          (DJ):    0.000ns
    Phase Error              (PE):    0.000ns

    Location             Delay type                Incr(ns)  Path(ns)    Netlist Resource(s)
  -------------------------------------------------------------------    -------------------
                         (clock clk_fpga_1 rise edge)
                                                      0.000     0.000 r  
    PS7_X0Y0             PS7                          0.000     0.000 r  system_i/system_i/ps7/inst/PS7_i/FCLKCLK[1]
                         net (fo=1, routed)           0.994     0.994    system_i/system_i/ps7/inst/FCLK_CLK_unbuffered[1]
    BUFGCTRL_X0Y17       BUFG (Prop_bufg_I_O)         0.085     1.079 r  system_i/system_i/ps7/inst/buffer_fclk_clk_1.FCLK_CLK_1_BUFG/O
                         net (fo=20890, routed)       1.452     2.531    system_i/system_i/qr_preprocess_0/inst/pl_roi.pipeline/geometry/aclk
    SLICE_X84Y23         FDRE                                         r  system_i/system_i/qr_preprocess_0/inst/pl_roi.pipeline/geometry/c1_reg[2]/C
  -------------------------------------------------------------------    -------------------
    SLICE_X84Y23         FDRE (Prop_fdre_C_Q)         0.379     2.910 r  system_i/system_i/qr_preprocess_0/inst/pl_roi.pipeline/geometry/c1_reg[2]/Q
                         net (fo=16, routed)          0.702     3.612    system_i/system_i/qr_preprocess_0/inst/pl_roi.pipeline/geometry/fx_return[2]
    SLICE_X83Y23         LUT4 (Prop_lut4_I1_O)        0.105     3.717 r  system_i/system_i/qr_preprocess_0/inst/pl_roi.pipeline/geometry/pending_maxx[15]_i_136/O
                         net (fo=1, routed)           0.000     3.717    system_i/system_i/qr_preprocess_0/inst/pl_roi.pipeline/geometry/pending_maxx[15]_i_136_n_0
    SLICE_X83Y23         CARRY4 (Prop_carry4_S[1]_CO[3])
                                                      0.457     4.174 r  system_i/system_i/qr_preprocess_0/inst/pl_roi.pipeline/geometry/pending_maxx_reg[15]_i_100/CO[3]
                         net (fo=1, routed)           0.000     4.174    system_i/system_i/qr_preprocess_0/inst/pl_roi.pipeline/geometry/pending_maxx_reg[15]_i_100_n_0
    SLICE_X83Y24         CARRY4 (Prop_carry4_CI_CO[3])
                                                      0.098     4.272 r  system_i/system_i/qr_preprocess_0/inst/pl_roi.pipeline/geometry/pending_maxx_reg[15]_i_68/CO[3]
                         net (fo=40, routed)          0.982     5.253    system_i/system_i/qr_preprocess_0/inst/pl_roi.pipeline/geometry/pending_maxx_reg[15]_i_68_n_0
    SLICE_X78Y24         LUT3 (Prop_lut3_I1_O)        0.124     5.377 f  system_i/system_i/qr_preprocess_0/inst/pl_roi.pipeline/geometry/pending_maxx[15]_i_128/O
                         net (fo=2, routed)           0.752     6.130    system_i/system_i/qr_preprocess_0/inst/pl_roi.pipeline/geometry/bbox_maxx[11]
    SLICE_X89Y28         LUT6 (Prop_lut6_I1_O)        0.267     6.397 r  system_i/system_i/qr_preprocess_0/inst/pl_roi.pipeline/geometry/pending_maxx[15]_i_94/O
                         net (fo=1, routed)           0.522     6.918    system_i/system_i/qr_preprocess_0/inst/pl_roi.pipeline/geometry/pending_maxx[15]_i_94_n_0
    SLICE_X89Y25         CARRY4 (Prop_carry4_DI[1]_CO[3])
                                                      0.418     7.336 r  system_i/system_i/qr_preprocess_0/inst/pl_roi.pipeline/geometry/pending_maxx_reg[15]_i_67/CO[3]
                         net (fo=16, routed)          1.284     8.620    system_i/system_i/qr_preprocess_0/inst/pl_roi.pipeline/geometry/pending_maxx_reg[15]_i_67_n_0
    SLICE_X78Y24         LUT5 (Prop_lut5_I1_O)        0.105     8.725 r  system_i/system_i/qr_preprocess_0/inst/pl_roi.pipeline/geometry/pending_maxx[11]_i_12/O
                         net (fo=4, routed)           0.657     9.382    system_i/system_i/qr_preprocess_0/inst/pl_roi.pipeline/geometry/pending_maxx[11]_i_12_n_0
    SLICE_X81Y28         LUT4 (Prop_lut4_I0_O)        0.105     9.487 r  system_i/system_i/qr_preprocess_0/inst/pl_roi.pipeline/geometry/pending_maxx[15]_i_116/O
                         net (fo=1, routed)           0.000     9.487    system_i/system_i/qr_preprocess_0/inst/pl_roi.pipeline/geometry/pending_maxx[15]_i_116_n_0
    SLICE_X81Y28         CARRY4 (Prop_carry4_S[1]_CO[3])
                                                      0.457     9.944 r  system_i/system_i/qr_preprocess_0/inst/pl_roi.pipeline/geometry/pending_maxx_reg[15]_i_85/CO[3]
                         net (fo=1, routed)           0.000     9.944    system_i/system_i/qr_preprocess_0/inst/pl_roi.pipeline/geometry/pending_maxx_reg[15]_i_85_n_0
    SLICE_X81Y29         CARRY4 (Prop_carry4_CI_CO[3])
                                                      0.098    10.042 r  system_i/system_i/qr_preprocess_0/inst/pl_roi.pipeline/geometry/pending_maxx_reg[15]_i_63/CO[3]
                         net (fo=1, routed)           0.000    10.042    system_i/system_i/qr_preprocess_0/inst/pl_roi.pipeline/geometry/pending_maxx_reg[15]_i_63_n_0
    SLICE_X81Y30         CARRY4 (Prop_carry4_CI_CO[3])
                                                      0.098    10.140 r  system_i/system_i/qr_preprocess_0/inst/pl_roi.pipeline/geometry/pending_maxx_reg[15]_i_31/CO[3]
                         net (fo=44, routed)          1.010    11.150    system_i/system_i/qr_preprocess_0/inst/pl_roi.pipeline/geometry/bbox_maxx1
    SLICE_X79Y27         LUT5 (Prop_lut5_I1_O)        0.105    11.255 r  system_i/system_i/qr_preprocess_0/inst/pl_roi.pipeline/geometry/pending_maxx[3]_i_9/O
                         net (fo=1, routed)           0.000    11.255    system_i/system_i/qr_preprocess_0/inst/pl_roi.pipeline/geometry/pending_maxx[3]_i_9_n_0
    SLICE_X79Y27         CARRY4 (Prop_carry4_S[1]_CO[3])
                                                      0.457    11.712 r  system_i/system_i/qr_preprocess_0/inst/pl_roi.pipeline/geometry/pending_maxx_reg[3]_i_2/CO[3]
                         net (fo=1, routed)           0.000    11.712    system_i/system_i/qr_preprocess_0/inst/pl_roi.pipeline/geometry/pending_maxx_reg[3]_i_2_n_0
    SLICE_X79Y28         CARRY4 (Prop_carry4_CI_CO[3])
                                                      0.098    11.810 r  system_i/system_i/qr_preprocess_0/inst/pl_roi.pipeline/geometry/pending_maxx_reg[7]_i_2/CO[3]
                         net (fo=1, routed)           0.000    11.810    system_i/system_i/qr_preprocess_0/inst/pl_roi.pipeline/geometry/pending_maxx_reg[7]_i_2_n_0
    SLICE_X79Y29         CARRY4 (Prop_carry4_CI_CO[3])
                                                      0.098    11.908 r  system_i/system_i/qr_preprocess_0/inst/pl_roi.pipeline/geometry/pending_maxx_reg[11]_i_2/CO[3]
                         net (fo=1, routed)           0.000    11.908    system_i/system_i/qr_preprocess_0/inst/pl_roi.pipeline/geometry/pending_maxx_reg[11]_i_2_n_0
    SLICE_X79Y30         CARRY4 (Prop_carry4_CI_CO[3])
                                                      0.098    12.006 r  system_i/system_i/qr_preprocess_0/inst/pl_roi.pipeline/geometry/pending_maxx_reg[15]_i_5/CO[3]
                         net (fo=1, routed)           0.000    12.006    system_i/system_i/qr_preprocess_0/inst/pl_roi.pipeline/geometry/pending_maxx_reg[15]_i_5_n_0
    SLICE_X79Y31         CARRY4 (Prop_carry4_CI_CO[3])
                                                      0.098    12.104 r  system_i/system_i/qr_preprocess_0/inst/pl_roi.pipeline/geometry/pending_maxx_reg[15]_i_46/CO[3]
                         net (fo=1, routed)           0.000    12.104    system_i/system_i/qr_preprocess_0/inst/pl_roi.pipeline/geometry/pending_maxx_reg[15]_i_46_n_0
    SLICE_X79Y32         CARRY4 (Prop_carry4_CI_CO[3])
                                                      0.098    12.202 r  system_i/system_i/qr_preprocess_0/inst/pl_roi.pipeline/geometry/pending_maxx_reg[15]_i_45/CO[3]
                         net (fo=1, routed)           0.000    12.202    system_i/system_i/qr_preprocess_0/inst/pl_roi.pipeline/geometry/pending_maxx_reg[15]_i_45_n_0
    SLICE_X79Y33         CARRY4 (Prop_carry4_CI_O[1])
                                                      0.265    12.467 f  system_i/system_i/qr_preprocess_0/inst/pl_roi.pipeline/geometry/pending_maxx_reg[15]_i_29/O[1]
                         net (fo=2, routed)           0.517    12.984    system_i/system_i/qr_preprocess_0/inst/pl_roi.pipeline/geometry/bbox_maxx0_out[25]
    SLICE_X78Y33         LUT2 (Prop_lut2_I0_O)        0.250    13.234 r  system_i/system_i/qr_preprocess_0/inst/pl_roi.pipeline/geometry/pending_maxx[15]_i_14/O
                         net (fo=1, routed)           0.000    13.234    system_i/system_i/qr_preprocess_0/inst/pl_roi.pipeline/geometry/pending_maxx[15]_i_14_n_0
    SLICE_X78Y33         CARRY4 (Prop_carry4_S[0]_CO[3])
                                                      0.440    13.674 r  system_i/system_i/qr_preprocess_0/inst/pl_roi.pipeline/geometry/pending_maxx_reg[15]_i_4/CO[3]
                         net (fo=17, routed)          1.088    14.761    system_i/system_i/qr_preprocess_0/inst/pl_roi.pipeline/geometry/pending_maxx2
    SLICE_X69Y20         LUT4 (Prop_lut4_I1_O)        0.105    14.866 r  system_i/system_i/qr_preprocess_0/inst/pl_roi.pipeline/geometry/pending_flags[0]_i_2/O
                         net (fo=1, routed)           0.262    15.128    system_i/system_i/qr_preprocess_0/inst/pl_roi.pipeline/geometry/selector/pending_flags3
    SLICE_X68Y20         LUT5 (Prop_lut5_I2_O)        0.105    15.233 r  system_i/system_i/qr_preprocess_0/inst/pl_roi.pipeline/geometry/selector/pending_flags[0]_i_1/O
                         net (fo=1, routed)           0.000    15.233    system_i/system_i/qr_preprocess_0/inst/pl_roi.pipeline/geometry/selector_n_387
    SLICE_X68Y20         FDRE                                         r  system_i/system_i/qr_preprocess_0/inst/pl_roi.pipeline/geometry/pending_flags_reg[0]/D
  -------------------------------------------------------------------    -------------------

                         (clock clk_fpga_1 rise edge)
                                                     12.999    12.999 r  
    PS7_X0Y0             PS7                          0.000    12.999 r  system_i/system_i/ps7/inst/PS7_i/FCLKCLK[1]
                         net (fo=1, routed)           0.905    13.904    system_i/system_i/ps7/inst/FCLK_CLK_unbuffered[1]
    BUFGCTRL_X0Y17       BUFG (Prop_bufg_I_O)         0.077    13.981 r  system_i/system_i/ps7/inst/buffer_fclk_clk_1.FCLK_CLK_1_BUFG/O
                         net (fo=20890, routed)       1.298    15.279    system_i/system_i/qr_preprocess_0/inst/pl_roi.pipeline/geometry/aclk
    SLICE_X68Y20         FDRE                                         r  system_i/system_i/qr_preprocess_0/inst/pl_roi.pipeline/geometry/pending_flags_reg[0]/C
                         clock pessimism              0.193    15.472    
                         clock uncertainty           -0.198    15.274    
    SLICE_X68Y20         FDRE (Setup_fdre_C_D)        0.032    15.306    system_i/system_i/qr_preprocess_0/inst/pl_roi.pipeline/geometry/pending_flags_reg[0]
  -------------------------------------------------------------------
                         required time                         15.306    
                         arrival time                         -15.233    
  -------------------------------------------------------------------
                         slack                                  0.072    

Min Delay Paths
--------------------------------------------------------------------------------------
Slack (MET) :             0.044ns  (arrival time - required time)
  Source:                 system_i/system_i/qr_preprocess_0/inst/pl_roi.pipeline/scanner/p0_x_reg[0][15]__0/C
                            (rising edge-triggered cell FDRE clocked by clk_fpga_1  {rise@0.000ns fall@6.499ns period=12.999ns})
  Destination:            system_i/system_i/qr_preprocess_0/inst/pl_roi.pipeline/scanner/p2_x_reg[0][15]_srl2/D
                            (rising edge-triggered cell SRL16E clocked by clk_fpga_1  {rise@0.000ns fall@6.499ns period=12.999ns})
  Path Group:             clk_fpga_1
  Path Type:              Hold (Min at Fast Process Corner)
  Requirement:            0.000ns  (clk_fpga_1 rise@0.000ns - clk_fpga_1 rise@0.000ns)
  Data Path Delay:        0.261ns  (logic 0.141ns (53.943%)  route 0.120ns (46.057%))
  Logic Levels:           0  
  Clock Path Skew:        0.034ns (DCD - SCD - CPR)
    Destination Clock Delay (DCD):    1.189ns
    Source Clock Delay      (SCD):    0.892ns
    Clock Pessimism Removal (CPR):    0.263ns

    Location             Delay type                Incr(ns)  Path(ns)    Netlist Resource(s)
  -------------------------------------------------------------------    -------------------
                         (clock clk_fpga_1 rise edge)
                                                      0.000     0.000 r  
    PS7_X0Y0             PS7                          0.000     0.000 r  system_i/system_i/ps7/inst/PS7_i/FCLKCLK[1]
                         net (fo=1, routed)           0.310     0.310    system_i/system_i/ps7/inst/FCLK_CLK_unbuffered[1]
    BUFGCTRL_X0Y17       BUFG (Prop_bufg_I_O)         0.026     0.336 r  system_i/system_i/ps7/inst/buffer_fclk_clk_1.FCLK_CLK_1_BUFG/O
                         net (fo=20890, routed)       0.556     0.891    system_i/system_i/qr_preprocess_0/inst/pl_roi.pipeline/scanner/aclk
    SLICE_X48Y16         FDRE                                         r  system_i/system_i/qr_preprocess_0/inst/pl_roi.pipeline/scanner/p0_x_reg[0][15]__0/C
  -------------------------------------------------------------------    -------------------
    SLICE_X48Y16         FDRE (Prop_fdre_C_Q)         0.141     1.033 r  system_i/system_i/qr_preprocess_0/inst/pl_roi.pipeline/scanner/p0_x_reg[0][15]__0/Q
                         net (fo=1, routed)           0.120     1.153    system_i/system_i/qr_preprocess_0/inst/pl_roi.pipeline/scanner/p0_x_reg[0][15]__0_n_0
    SLICE_X46Y15         SRL16E                                       r  system_i/system_i/qr_preprocess_0/inst/pl_roi.pipeline/scanner/p2_x_reg[0][15]_srl2/D
  -------------------------------------------------------------------    -------------------

                         (clock clk_fpga_1 rise edge)
                                                      0.000     0.000 r  
    PS7_X0Y0             PS7                          0.000     0.000 r  system_i/system_i/ps7/inst/PS7_i/FCLKCLK[1]
                         net (fo=1, routed)           0.337     0.337    system_i/system_i/ps7/inst/FCLK_CLK_unbuffered[1]
    BUFGCTRL_X0Y17       BUFG (Prop_bufg_I_O)         0.029     0.366 r  system_i/system_i/ps7/inst/buffer_fclk_clk_1.FCLK_CLK_1_BUFG/O
                         net (fo=20890, routed)       0.823     1.189    system_i/system_i/qr_preprocess_0/inst/pl_roi.pipeline/scanner/aclk
    SLICE_X46Y15         SRL16E                                       r  system_i/system_i/qr_preprocess_0/inst/pl_roi.pipeline/scanner/p2_x_reg[0][15]_srl2/CLK
                         clock pessimism             -0.263     0.926    
    SLICE_X46Y15         SRL16E (Hold_srl16e_CLK_D)
                                                      0.183     1.109    system_i/system_i/qr_preprocess_0/inst/pl_roi.pipeline/scanner/p2_x_reg[0][15]_srl2
  -------------------------------------------------------------------
                         required time                         -1.109    
                         arrival time                           1.153    
  -------------------------------------------------------------------
                         slack                                  0.044    

Pulse Width Checks
--------------------------------------------------------------------------------------
Clock Name:         clk_fpga_1
Waveform(ns):       { 0.000 6.499 }
Period(ns):         12.999
Sources:            { system_i/system_i/ps7/inst/PS7_i/FCLKCLK[1] }

Check Type        Corner  Lib Pin      Reference Pin  Required(ns)  Actual(ns)  Slack(ns)  Location      Pin
Min Period        n/a     DSP48E1/CLK  n/a            3.272         12.999      9.727      DSP48_X1Y5    system_i/system_i/qr_preprocess_0/inst/pl_roi.pipeline/diag_scan.diagonals/down_left/p2_bound_reg/CLK
Low Pulse Width   Slow    RAMD32/CLK   n/a            1.130         6.500       5.369      SLICE_X42Y70  system_i/system_i/qr_capture_cdc/inst/gen_async_conv.axisc_async_clock_converter_0/xpm_fifo_async_inst/gnuram_async_fifo.xpm_fifo_base_inst/gen_sdpram.xpm_memory_base_inst/gen_wr_a.gen_word_narrow.mem_reg_0_31_0_5/RAMA/CLK
High Pulse Width  Slow    RAMD32/CLK   n/a            1.130         6.499       5.369      SLICE_X42Y70  system_i/system_i/qr_capture_cdc/inst/gen_async_conv.axisc_async_clock_converter_0/xpm_fifo_async_inst/gnuram_async_fifo.xpm_fifo_base_inst/gen_sdpram.xpm_memory_base_inst/gen_wr_a.gen_word_narrow.mem_reg_0_31_0_5/RAMA/CLK

---------------------------------------------------------------------------------------------------
From Clock:  system_i/system_i/pixel_clock/inst/clk_in1
  To Clock:  system_i/system_i/pixel_clock/inst/clk_in1

Setup :           NA  Failing Endpoints,  Worst Slack           NA  ,  Total Violation           NA
Hold  :           NA  Failing Endpoints,  Worst Slack           NA  ,  Total Violation           NA
PW    :            0  Failing Endpoints,  Worst Slack        3.000ns,  Total Violation        0.000ns
---------------------------------------------------------------------------------------------------

Pulse Width Checks
--------------------------------------------------------------------------------------
Clock Name:         system_i/system_i/pixel_clock/inst/clk_in1
Waveform(ns):       { 0.000 5.000 }
Period(ns):         10.000
Sources:            { system_i/system_i/pixel_clock/inst/clk_in1 }

Check Type        Corner  Lib Pin            Reference Pin  Required(ns)  Actual(ns)  Slack(ns)  Location         Pin
Min Period        n/a     MMCME2_ADV/CLKIN1  n/a            1.249         10.000      8.751      MMCME2_ADV_X1Y0  system_i/system_i/pixel_clock/inst/mmcm_adv_inst/CLKIN1
Max Period        n/a     MMCME2_ADV/CLKIN1  n/a            100.000       10.000      90.000     MMCME2_ADV_X1Y0  system_i/system_i/pixel_clock/inst/mmcm_adv_inst/CLKIN1
Low Pulse Width   Slow    MMCME2_ADV/CLKIN1  n/a            2.000         5.000       3.000      MMCME2_ADV_X1Y0  system_i/system_i/pixel_clock/inst/mmcm_adv_inst/CLKIN1
High Pulse Width  Slow    MMCME2_ADV/CLKIN1  n/a            2.000         5.000       3.000      MMCME2_ADV_X1Y0  system_i/system_i/pixel_clock/inst/mmcm_adv_inst/CLKIN1

---------------------------------------------------------------------------------------------------
From Clock:  clk_out1_system_pixel_clock_0
  To Clock:  clk_out1_system_pixel_clock_0

Setup :            0  Failing Endpoints,  Worst Slack        2.126ns,  Total Violation        0.000ns
Hold  :            0  Failing Endpoints,  Worst Slack        0.108ns,  Total Violation        0.000ns
PW    :            0  Failing Endpoints,  Worst Slack        5.880ns,  Total Violation        0.000ns
---------------------------------------------------------------------------------------------------

Max Delay Paths
--------------------------------------------------------------------------------------
Slack (MET) :             2.126ns  (required time - arrival time)
  Source:                 system_i/system_i/video_timing/inst/raw_y_reg[1]/C
                            (rising edge-triggered cell FDRE clocked by clk_out1_system_pixel_clock_0  {rise@0.000ns fall@6.734ns period=13.468ns})
  Destination:            system_i/system_i/display_osd/inst/chars0_reg/ADDRARDADDR[10]
                            (rising edge-triggered cell RAMB18E1 clocked by clk_out1_system_pixel_clock_0  {rise@0.000ns fall@6.734ns period=13.468ns})
  Path Group:             clk_out1_system_pixel_clock_0
  Path Type:              Setup (Max at Slow Process Corner)
  Requirement:            13.468ns  (clk_out1_system_pixel_clock_0 rise@13.468ns - clk_out1_system_pixel_clock_0 rise@0.000ns)
  Data Path Delay:        10.584ns  (logic 2.556ns (24.149%)  route 8.028ns (75.851%))
  Logic Levels:           11  (CARRY4=4 LUT2=1 LUT4=1 LUT5=2 LUT6=3)
  Clock Path Skew:        0.011ns (DCD - SCD + CPR)
    Destination Clock Delay (DCD):    1.398ns = ( 14.867 - 13.468 ) 
    Source Clock Delay      (SCD):    1.399ns
    Clock Pessimism Removal (CPR):    0.012ns
  Clock Uncertainty:      0.128ns  ((TSJ^2 + DJ^2)^1/2) / 2 + PE
    Total System Jitter     (TSJ):    0.071ns
    Discrete Jitter          (DJ):    0.245ns
    Phase Error              (PE):    0.000ns

    Location             Delay type                Incr(ns)  Path(ns)    Netlist Resource(s)
  -------------------------------------------------------------------    -------------------
                         (clock clk_out1_system_pixel_clock_0 rise edge)
                                                      0.000     0.000 r  
    BUFGCTRL_X0Y16       BUFG                         0.000     0.000 r  system_i/system_i/ps7/inst/buffer_fclk_clk_0.FCLK_CLK_0_BUFG/O
                         net (fo=28349, routed)       1.552     1.552    system_i/system_i/pixel_clock/inst/clk_in1
    MMCME2_ADV_X1Y0      MMCME2_ADV (Prop_mmcme2_adv_CLKIN1_CLKOUT0)
                                                     -3.232    -1.680 r  system_i/system_i/pixel_clock/inst/mmcm_adv_inst/CLKOUT0
                         net (fo=1, routed)           1.597    -0.083    system_i/system_i/pixel_clock/inst/clk_out1_system_pixel_clock_0
    BUFGCTRL_X0Y0        BUFG (Prop_bufg_I_O)         0.085     0.002 r  system_i/system_i/pixel_clock/inst/clkout1_buf/O
                         net (fo=1043, routed)        1.397     1.399    system_i/system_i/video_timing/inst/pixel_clk
    SLICE_X35Y31         FDRE                                         r  system_i/system_i/video_timing/inst/raw_y_reg[1]/C
  -------------------------------------------------------------------    -------------------
    SLICE_X35Y31         FDRE (Prop_fdre_C_Q)         0.379     1.778 r  system_i/system_i/video_timing/inst/raw_y_reg[1]/Q
                         net (fo=114, routed)         1.532     3.310    system_i/system_i/display_osd/inst/pixel_y[1]
    SLICE_X1Y25          LUT2 (Prop_lut2_I0_O)        0.105     3.415 r  system_i/system_i/display_osd/inst/col0[0]_i_173/O
                         net (fo=1, routed)           0.000     3.415    system_i/system_i/display_osd/inst/col0[0]_i_173_n_0
    SLICE_X1Y25          CARRY4 (Prop_carry4_S[1]_CO[3])
                                                      0.457     3.872 r  system_i/system_i/display_osd/inst/col0_reg[0]_i_135/CO[3]
                         net (fo=1, routed)           0.000     3.872    system_i/system_i/display_osd/inst/col0_reg[0]_i_135_n_0
    SLICE_X1Y26          CARRY4 (Prop_carry4_CI_CO[3])
                                                      0.098     3.970 r  system_i/system_i/display_osd/inst/col0_reg[0]_i_85/CO[3]
                         net (fo=1, routed)           0.000     3.970    system_i/system_i/display_osd/inst/col0_reg[0]_i_85_n_0
    SLICE_X1Y27          CARRY4 (Prop_carry4_CI_CO[2])
                                                      0.190     4.160 r  system_i/system_i/display_osd/inst/col0_reg[0]_i_31/CO[2]
                         net (fo=1, routed)           0.595     4.755    system_i/system_i/display_osd/inst/col0_reg[0]_i_31_n_1
    SLICE_X4Y26          LUT5 (Prop_lut5_I1_O)        0.261     5.016 r  system_i/system_i/display_osd/inst/col0[0]_i_10/O
                         net (fo=23, routed)          0.614     5.630    system_i/system_i/display_osd/inst/col0[0]_i_10_n_0
    SLICE_X8Y23          LUT6 (Prop_lut6_I5_O)        0.105     5.735 f  system_i/system_i/display_osd/inst/area0_i_4/O
                         net (fo=13, routed)          0.755     6.490    system_i/system_i/display_osd/inst/area0_i_4_n_0
    SLICE_X0Y22          LUT5 (Prop_lut5_I4_O)        0.105     6.595 r  system_i/system_i/display_osd/inst/chars0_reg_i_153/O
                         net (fo=1, routed)           0.551     7.145    system_i/system_i/display_osd/inst/chars0_reg_i_153_n_0
    SLICE_X0Y22          LUT6 (Prop_lut6_I0_O)        0.105     7.250 r  system_i/system_i/display_osd/inst/chars0_reg_i_73/O
                         net (fo=1, routed)           0.711     7.961    system_i/system_i/display_osd/inst/chars0_reg_i_73_n_0
    SLICE_X19Y22         LUT6 (Prop_lut6_I1_O)        0.105     8.066 r  system_i/system_i/display_osd/inst/chars0_reg_i_39/O
                         net (fo=4, routed)           0.864     8.930    system_i/system_i/display_osd/inst/local_y7_out[5]
    SLICE_X19Y27         LUT4 (Prop_lut4_I3_O)        0.121     9.051 r  system_i/system_i/display_osd/inst/chars0_reg_i_16/O
                         net (fo=1, routed)           0.366     9.417    system_i/system_i/display_osd/inst/chars0_reg_i_16_n_0
    SLICE_X19Y28         CARRY4 (Prop_carry4_DI[2]_O[3])
                                                      0.525     9.942 r  system_i/system_i/display_osd/inst/chars0_reg_i_3/O[3]
                         net (fo=2, routed)           2.041    11.983    system_i/system_i/display_osd/inst/p_2_in[5]
    RAMB18_X4Y14         RAMB18E1                                     r  system_i/system_i/display_osd/inst/chars0_reg/ADDRARDADDR[10]
  -------------------------------------------------------------------    -------------------

                         (clock clk_out1_system_pixel_clock_0 rise edge)
                                                     13.468    13.468 r  
    BUFGCTRL_X0Y16       BUFG                         0.000    13.468 r  system_i/system_i/ps7/inst/buffer_fclk_clk_0.FCLK_CLK_0_BUFG/O
                         net (fo=28349, routed)       1.386    14.854    system_i/system_i/pixel_clock/inst/clk_in1
    MMCME2_ADV_X1Y0      MMCME2_ADV (Prop_mmcme2_adv_CLKIN1_CLKOUT0)
                                                     -2.915    11.939 r  system_i/system_i/pixel_clock/inst/mmcm_adv_inst/CLKOUT0
                         net (fo=1, routed)           1.454    13.393    system_i/system_i/pixel_clock/inst/clk_out1_system_pixel_clock_0
    BUFGCTRL_X0Y0        BUFG (Prop_bufg_I_O)         0.077    13.470 r  system_i/system_i/pixel_clock/inst/clkout1_buf/O
                         net (fo=1043, routed)        1.396    14.867    system_i/system_i/display_osd/inst/pixel_clk
    RAMB18_X4Y14         RAMB18E1                                     r  system_i/system_i/display_osd/inst/chars0_reg/CLKARDCLK
                         clock pessimism              0.012    14.879    
                         clock uncertainty           -0.128    14.751    
    RAMB18_X4Y14         RAMB18E1 (Setup_ramb18e1_CLKARDCLK_ADDRARDADDR[10])
                                                     -0.642    14.109    system_i/system_i/display_osd/inst/chars0_reg
  -------------------------------------------------------------------
                         required time                         14.109    
                         arrival time                         -11.983    
  -------------------------------------------------------------------
                         slack                                  2.126    

Min Delay Paths
--------------------------------------------------------------------------------------
Slack (MET) :             0.108ns  (arrival time - required time)
  Source:                 system_i/system_i/display_vdma/U0/GEN_SPRT_FOR_MM2S.MM2S_LINEBUFFER_I/GEN_LINEBUF_NO_SOF.GEN_LINEBUFFER.I_MSTR_SKID/sig_data_skid_reg_reg[8]/C
                            (rising edge-triggered cell FDRE clocked by clk_out1_system_pixel_clock_0  {rise@0.000ns fall@6.734ns period=13.468ns})
  Destination:            system_i/system_i/display_vdma/U0/GEN_SPRT_FOR_MM2S.MM2S_LINEBUFFER_I/GEN_LINEBUF_NO_SOF.GEN_LINEBUFFER.I_MSTR_SKID/sig_data_reg_out_reg[8]/D
                            (rising edge-triggered cell FDRE clocked by clk_out1_system_pixel_clock_0  {rise@0.000ns fall@6.734ns period=13.468ns})
  Path Group:             clk_out1_system_pixel_clock_0
  Path Type:              Hold (Min at Fast Process Corner)
  Requirement:            0.000ns  (clk_out1_system_pixel_clock_0 rise@0.000ns - clk_out1_system_pixel_clock_0 rise@0.000ns)
  Data Path Delay:        0.241ns  (logic 0.186ns (77.036%)  route 0.055ns (22.964%))
  Logic Levels:           1  (LUT3=1)
  Clock Path Skew:        0.013ns (DCD - SCD - CPR)
    Destination Clock Delay (DCD):    0.859ns
    Source Clock Delay      (SCD):    0.591ns
    Clock Pessimism Removal (CPR):    0.255ns

    Location             Delay type                Incr(ns)  Path(ns)    Netlist Resource(s)
  -------------------------------------------------------------------    -------------------
                         (clock clk_out1_system_pixel_clock_0 rise edge)
                                                      0.000     0.000 r  
    BUFGCTRL_X0Y16       BUFG                         0.000     0.000 r  system_i/system_i/ps7/inst/buffer_fclk_clk_0.FCLK_CLK_0_BUFG/O
                         net (fo=28349, routed)       0.597     0.597    system_i/system_i/pixel_clock/inst/clk_in1
    MMCME2_ADV_X1Y0      MMCME2_ADV (Prop_mmcme2_adv_CLKIN1_CLKOUT0)
                                                     -1.150    -0.553 r  system_i/system_i/pixel_clock/inst/mmcm_adv_inst/CLKOUT0
                         net (fo=1, routed)           0.529    -0.024    system_i/system_i/pixel_clock/inst/clk_out1_system_pixel_clock_0
    BUFGCTRL_X0Y0        BUFG (Prop_bufg_I_O)         0.026     0.002 r  system_i/system_i/pixel_clock/inst/clkout1_buf/O
                         net (fo=1043, routed)        0.589     0.591    system_i/system_i/display_vdma/U0/GEN_SPRT_FOR_MM2S.MM2S_LINEBUFFER_I/GEN_LINEBUF_NO_SOF.GEN_LINEBUFFER.I_MSTR_SKID/m_axis_mm2s_aclk
    SLICE_X31Y48         FDRE                                         r  system_i/system_i/display_vdma/U0/GEN_SPRT_FOR_MM2S.MM2S_LINEBUFFER_I/GEN_LINEBUF_NO_SOF.GEN_LINEBUFFER.I_MSTR_SKID/sig_data_skid_reg_reg[8]/C
  -------------------------------------------------------------------    -------------------
    SLICE_X31Y48         FDRE (Prop_fdre_C_Q)         0.141     0.732 r  system_i/system_i/display_vdma/U0/GEN_SPRT_FOR_MM2S.MM2S_LINEBUFFER_I/GEN_LINEBUF_NO_SOF.GEN_LINEBUFFER.I_MSTR_SKID/sig_data_skid_reg_reg[8]/Q
                         net (fo=1, routed)           0.055     0.787    system_i/system_i/display_vdma/U0/GEN_SPRT_FOR_MM2S.MM2S_LINEBUFFER_I/GEN_LINEBUF_NO_SOF.GEN_LINEBUFFER.I_MSTR_SKID/sig_data_skid_reg[8]
    SLICE_X30Y48         LUT3 (Prop_lut3_I2_O)        0.045     0.832 r  system_i/system_i/display_vdma/U0/GEN_SPRT_FOR_MM2S.MM2S_LINEBUFFER_I/GEN_LINEBUF_NO_SOF.GEN_LINEBUFFER.I_MSTR_SKID/sig_data_reg_out[8]_i_1/O
                         net (fo=1, routed)           0.000     0.832    system_i/system_i/display_vdma/U0/GEN_SPRT_FOR_MM2S.MM2S_LINEBUFFER_I/GEN_LINEBUF_NO_SOF.GEN_LINEBUFFER.I_MSTR_SKID/sig_data_skid_mux_out[8]
    SLICE_X30Y48         FDRE                                         r  system_i/system_i/display_vdma/U0/GEN_SPRT_FOR_MM2S.MM2S_LINEBUFFER_I/GEN_LINEBUF_NO_SOF.GEN_LINEBUFFER.I_MSTR_SKID/sig_data_reg_out_reg[8]/D
  -------------------------------------------------------------------    -------------------

                         (clock clk_out1_system_pixel_clock_0 rise edge)
                                                      0.000     0.000 r  
    BUFGCTRL_X0Y16       BUFG                         0.000     0.000 r  system_i/system_i/ps7/inst/buffer_fclk_clk_0.FCLK_CLK_0_BUFG/O
                         net (fo=28349, routed)       0.864     0.864    system_i/system_i/pixel_clock/inst/clk_in1
    MMCME2_ADV_X1Y0      MMCME2_ADV (Prop_mmcme2_adv_CLKIN1_CLKOUT0)
                                                     -1.467    -0.603 r  system_i/system_i/pixel_clock/inst/mmcm_adv_inst/CLKOUT0
                         net (fo=1, routed)           0.576    -0.027    system_i/system_i/pixel_clock/inst/clk_out1_system_pixel_clock_0
    BUFGCTRL_X0Y0        BUFG (Prop_bufg_I_O)         0.029     0.002 r  system_i/system_i/pixel_clock/inst/clkout1_buf/O
                         net (fo=1043, routed)        0.857     0.859    system_i/system_i/display_vdma/U0/GEN_SPRT_FOR_MM2S.MM2S_LINEBUFFER_I/GEN_LINEBUF_NO_SOF.GEN_LINEBUFFER.I_MSTR_SKID/m_axis_mm2s_aclk
    SLICE_X30Y48         FDRE                                         r  system_i/system_i/display_vdma/U0/GEN_SPRT_FOR_MM2S.MM2S_LINEBUFFER_I/GEN_LINEBUF_NO_SOF.GEN_LINEBUFFER.I_MSTR_SKID/sig_data_reg_out_reg[8]/C
                         clock pessimism             -0.255     0.604    
    SLICE_X30Y48         FDRE (Hold_fdre_C_D)         0.120     0.724    system_i/system_i/display_vdma/U0/GEN_SPRT_FOR_MM2S.MM2S_LINEBUFFER_I/GEN_LINEBUF_NO_SOF.GEN_LINEBUFFER.I_MSTR_SKID/sig_data_reg_out_reg[8]
  -------------------------------------------------------------------
                         required time                         -0.724    
                         arrival time                           0.832    
  -------------------------------------------------------------------
                         slack                                  0.108    

Pulse Width Checks
--------------------------------------------------------------------------------------
Clock Name:         clk_out1_system_pixel_clock_0
Waveform(ns):       { 0.000 6.734 }
Period(ns):         13.468
Sources:            { system_i/system_i/pixel_clock/inst/mmcm_adv_inst/CLKOUT0 }

Check Type        Corner  Lib Pin             Reference Pin  Required(ns)  Actual(ns)  Slack(ns)  Location         Pin
Min Period        n/a     RAMB36E1/CLKARDCLK  n/a            2.170         13.468      11.298     RAMB36_X3Y12     system_i/system_i/display_identity/inst/tags_reg/CLKARDCLK
Max Period        n/a     MMCME2_ADV/CLKOUT0  n/a            213.360       13.468      199.892    MMCME2_ADV_X1Y0  system_i/system_i/pixel_clock/inst/mmcm_adv_inst/CLKOUT0
Low Pulse Width   Slow    SRL16E/CLK          n/a            0.854         6.734       5.880      SLICE_X30Y49     qr_desktop_top/system_wrapper/system/system_display_vdma_0/system_display_vdma_0_axi_vdma/system_display_vdma_0_axi_vdma_mm2s_linebuf/system_display_vdma_0_axi_vdma_afifo_builtin/<hidden>/<hidden>/<hidden>/<hidden>/<hidden>
High Pulse Width  Slow    SRL16E/CLK          n/a            0.854         6.734       5.880      SLICE_X30Y49     qr_desktop_top/system_wrapper/system/system_display_vdma_0/system_display_vdma_0_axi_vdma/system_display_vdma_0_axi_vdma_mm2s_linebuf/system_display_vdma_0_axi_vdma_afifo_builtin/<hidden>/<hidden>/<hidden>/<hidden>/<hidden>

---------------------------------------------------------------------------------------------------
From Clock:  clkfbout_system_pixel_clock_0
  To Clock:  clkfbout_system_pixel_clock_0

Setup :           NA  Failing Endpoints,  Worst Slack           NA  ,  Total Violation           NA
Hold  :           NA  Failing Endpoints,  Worst Slack           NA  ,  Total Violation           NA
PW    :            0  Failing Endpoints,  Worst Slack       38.408ns,  Total Violation        0.000ns
---------------------------------------------------------------------------------------------------

Pulse Width Checks
--------------------------------------------------------------------------------------
Clock Name:         clkfbout_system_pixel_clock_0
Waveform(ns):       { 0.000 20.000 }
Period(ns):         40.000
Sources:            { system_i/system_i/pixel_clock/inst/mmcm_adv_inst/CLKFBOUT }

Check Type  Corner  Lib Pin             Reference Pin  Required(ns)  Actual(ns)  Slack(ns)  Location         Pin
Min Period  n/a     BUFG/I              n/a            1.592         40.000      38.408     BUFGCTRL_X0Y2    system_i/system_i/pixel_clock/inst/clkf_buf/I
Max Period  n/a     MMCME2_ADV/CLKFBIN  n/a            100.000       40.000      60.000     MMCME2_ADV_X1Y0  system_i/system_i/pixel_clock/inst/mmcm_adv_inst/CLKFBIN

---------------------------------------------------------------------------------------------------
From Clock:  clk_fpga_0
  To Clock:  cam1_pclk

Setup :            0  Failing Endpoints,  Worst Slack        7.871ns,  Total Violation        0.000ns
Hold  :           NA  Failing Endpoints,  Worst Slack           NA  ,  Total Violation           NA
---------------------------------------------------------------------------------------------------

Max Delay Paths
--------------------------------------------------------------------------------------
Slack (MET) :             7.871ns  (required time - arrival time)
  Source:                 system_i/system_i/display_osd/inst/source_epoch_reg[16]/C
                            (rising edge-triggered cell FDRE clocked by clk_fpga_0  {rise@0.000ns fall@5.000ns period=10.000ns})
  Destination:            epoch0_reg[16]/D
                            (rising edge-triggered cell FDRE clocked by cam1_pclk  {rise@0.000ns fall@4.850ns period=9.700ns})
  Path Group:             cam1_pclk
  Path Type:              Setup (Max at Slow Process Corner)
  Requirement:            9.700ns  (MaxDelay Path 9.700ns)
  Data Path Delay:        1.754ns  (logic 0.379ns (21.605%)  route 1.375ns (78.395%))
  Logic Levels:           0  
  Timing Exception:       MaxDelay Path 9.700ns -datapath_only

    Location             Delay type                Incr(ns)  Path(ns)    Netlist Resource(s)
  -------------------------------------------------------------------    -------------------
    SLICE_X59Y45                                      0.000     0.000 r  system_i/system_i/display_osd/inst/source_epoch_reg[16]/C
    SLICE_X59Y45         FDRE (Prop_fdre_C_Q)         0.379     0.379 r  system_i/system_i/display_osd/inst/source_epoch_reg[16]/Q
                         net (fo=2, routed)           1.375     1.754    source_epoch[16]
    SLICE_X48Y50         FDRE                                         r  epoch0_reg[16]/D
  -------------------------------------------------------------------    -------------------

                         max delay                    9.700     9.700    
    SLICE_X48Y50         FDRE (Setup_fdre_C_D)       -0.075     9.625    epoch0_reg[16]
  -------------------------------------------------------------------
                         required time                          9.625    
                         arrival time                          -1.754    
  -------------------------------------------------------------------
                         slack                                  7.871    

---------------------------------------------------------------------------------------------------
From Clock:  clk_fpga_1
  To Clock:  cam1_pclk

Setup :            0  Failing Endpoints,  Worst Slack       11.714ns,  Total Violation        0.000ns
Hold  :           NA  Failing Endpoints,  Worst Slack           NA  ,  Total Violation           NA
---------------------------------------------------------------------------------------------------

Max Delay Paths
--------------------------------------------------------------------------------------
Slack (MET) :             11.714ns  (required time - arrival time)
  Source:                 system_i/system_i/qr_camera_cdc/inst/gen_async_conv.axisc_async_clock_converter_0/xpm_fifo_async_inst/gnuram_async_fifo.xpm_fifo_base_inst/gen_cdc_pntr.rd_pntr_cdc_inst/src_gray_ff_reg[3]/C
                            (rising edge-triggered cell FDRE clocked by clk_fpga_1  {rise@0.000ns fall@6.499ns period=12.999ns})
  Destination:            system_i/system_i/qr_camera_cdc/inst/gen_async_conv.axisc_async_clock_converter_0/xpm_fifo_async_inst/gnuram_async_fifo.xpm_fifo_base_inst/gen_cdc_pntr.rd_pntr_cdc_inst/dest_graysync_ff_reg[0][3]/D
                            (rising edge-triggered cell FDRE clocked by cam1_pclk  {rise@0.000ns fall@4.850ns period=9.700ns})
  Path Group:             cam1_pclk
  Path Type:              Setup (Max at Slow Process Corner)
  Requirement:            12.999ns  (MaxDelay Path 12.999ns)
  Data Path Delay:        1.078ns  (logic 0.348ns (32.268%)  route 0.730ns (67.732%))
  Logic Levels:           0  
  Timing Exception:       MaxDelay Path 12.999ns -datapath_only

    Location             Delay type                Incr(ns)  Path(ns)    Netlist Resource(s)
  -------------------------------------------------------------------    -------------------
    SLICE_X49Y45                                      0.000     0.000 r  system_i/system_i/qr_camera_cdc/inst/gen_async_conv.axisc_async_clock_converter_0/xpm_fifo_async_inst/gnuram_async_fifo.xpm_fifo_base_inst/gen_cdc_pntr.rd_pntr_cdc_inst/src_gray_ff_reg[3]/C
    SLICE_X49Y45         FDRE (Prop_fdre_C_Q)         0.348     0.348 r  system_i/system_i/qr_camera_cdc/inst/gen_async_conv.axisc_async_clock_converter_0/xpm_fifo_async_inst/gnuram_async_fifo.xpm_fifo_base_inst/gen_cdc_pntr.rd_pntr_cdc_inst/src_gray_ff_reg[3]/Q
                         net (fo=1, routed)           0.730     1.078    system_i/system_i/qr_camera_cdc/inst/gen_async_conv.axisc_async_clock_converter_0/xpm_fifo_async_inst/gnuram_async_fifo.xpm_fifo_base_inst/gen_cdc_pntr.rd_pntr_cdc_inst/async_path[3]
    SLICE_X48Y45         FDRE                                         r  system_i/system_i/qr_camera_cdc/inst/gen_async_conv.axisc_async_clock_converter_0/xpm_fifo_async_inst/gnuram_async_fifo.xpm_fifo_base_inst/gen_cdc_pntr.rd_pntr_cdc_inst/dest_graysync_ff_reg[0][3]/D
  -------------------------------------------------------------------    -------------------

                         max delay                   12.999    12.999    
    SLICE_X48Y45         FDRE (Setup_fdre_C_D)       -0.207    12.792    system_i/system_i/qr_camera_cdc/inst/gen_async_conv.axisc_async_clock_converter_0/xpm_fifo_async_inst/gnuram_async_fifo.xpm_fifo_base_inst/gen_cdc_pntr.rd_pntr_cdc_inst/dest_graysync_ff_reg[0][3]
  -------------------------------------------------------------------
                         required time                         12.792    
                         arrival time                          -1.078    
  -------------------------------------------------------------------
                         slack                                 11.714    

---------------------------------------------------------------------------------------------------
From Clock:  cam1_pclk
  To Clock:  clk_fpga_0

Setup :            0  Failing Endpoints,  Worst Slack        6.760ns,  Total Violation        0.000ns
Hold  :           NA  Failing Endpoints,  Worst Slack           NA  ,  Total Violation           NA
---------------------------------------------------------------------------------------------------

Max Delay Paths
--------------------------------------------------------------------------------------
Slack (MET) :             6.760ns  (required time - arrival time)
  Source:                 system_i/system_i/display_camera_cdc/inst/gen_async_conv.axisc_async_clock_converter_0/xpm_fifo_async_inst/gnuram_async_fifo.xpm_fifo_base_inst/gen_sdpram.xpm_memory_base_inst/gen_wr_a.gen_word_narrow.mem_reg_0_31_48_53/RAMC/CLK
                            (rising edge-triggered cell RAMD32 clocked by cam1_pclk  {rise@0.000ns fall@4.850ns period=9.700ns})
  Destination:            system_i/system_i/display_camera_cdc/inst/gen_async_conv.axisc_async_clock_converter_0/xpm_fifo_async_inst/gnuram_async_fifo.xpm_fifo_base_inst/gen_sdpram.xpm_memory_base_inst/gen_rd_b.gen_rd_b_synth_template.gen_rf_narrow_pipe.doutb_reg_reg[52]/D
                            (rising edge-triggered cell FDRE clocked by clk_fpga_0  {rise@0.000ns fall@5.000ns period=10.000ns})
  Path Group:             clk_fpga_0
  Path Type:              Setup (Max at Slow Process Corner)
  Requirement:            9.700ns  (MaxDelay Path 9.700ns)
  Data Path Delay:        2.698ns  (logic 1.100ns (40.764%)  route 1.598ns (59.236%))
  Logic Levels:           0  
  Timing Exception:       MaxDelay Path 9.700ns -datapath_only

    Location             Delay type                Incr(ns)  Path(ns)    Netlist Resource(s)
  -------------------------------------------------------------------    -------------------
    SLICE_X50Y51                                      0.000     0.000 r  system_i/system_i/display_camera_cdc/inst/gen_async_conv.axisc_async_clock_converter_0/xpm_fifo_async_inst/gnuram_async_fifo.xpm_fifo_base_inst/gen_sdpram.xpm_memory_base_inst/gen_wr_a.gen_word_narrow.mem_reg_0_31_48_53/RAMC/CLK
    SLICE_X50Y51         RAMD32 (Prop_ramd32_CLK_O)
                                                      1.100     1.100 r  system_i/system_i/display_camera_cdc/inst/gen_async_conv.axisc_async_clock_converter_0/xpm_fifo_async_inst/gnuram_async_fifo.xpm_fifo_base_inst/gen_sdpram.xpm_memory_base_inst/gen_wr_a.gen_word_narrow.mem_reg_0_31_48_53/RAMC/O
                         net (fo=1, routed)           1.598     2.698    system_i/system_i/display_camera_cdc/inst/gen_async_conv.axisc_async_clock_converter_0/xpm_fifo_async_inst/gnuram_async_fifo.xpm_fifo_base_inst/gen_sdpram.xpm_memory_base_inst/gen_rd_b.gen_rd_b_synth_template.gen_rf_narrow_pipe.doutb_reg_reg0[52]
    SLICE_X85Y42         FDRE                                         r  system_i/system_i/display_camera_cdc/inst/gen_async_conv.axisc_async_clock_converter_0/xpm_fifo_async_inst/gnuram_async_fifo.xpm_fifo_base_inst/gen_sdpram.xpm_memory_base_inst/gen_rd_b.gen_rd_b_synth_template.gen_rf_narrow_pipe.doutb_reg_reg[52]/D
  -------------------------------------------------------------------    -------------------

                         max delay                    9.700     9.700    
    SLICE_X85Y42         FDRE (Setup_fdre_C_D)       -0.242     9.458    system_i/system_i/display_camera_cdc/inst/gen_async_conv.axisc_async_clock_converter_0/xpm_fifo_async_inst/gnuram_async_fifo.xpm_fifo_base_inst/gen_sdpram.xpm_memory_base_inst/gen_rd_b.gen_rd_b_synth_template.gen_rf_narrow_pipe.doutb_reg_reg[52]
  -------------------------------------------------------------------
                         required time                          9.458    
                         arrival time                          -2.698    
  -------------------------------------------------------------------
                         slack                                  6.760    

---------------------------------------------------------------------------------------------------
From Clock:  clk_fpga_1
  To Clock:  clk_fpga_0

Setup :            0  Failing Endpoints,  Worst Slack       10.499ns,  Total Violation        0.000ns
Hold  :           NA  Failing Endpoints,  Worst Slack           NA  ,  Total Violation           NA
---------------------------------------------------------------------------------------------------

Max Delay Paths
--------------------------------------------------------------------------------------
Slack (MET) :             10.499ns  (required time - arrival time)
  Source:                 system_i/system_i/qr_capture_cdc/inst/gen_async_conv.axisc_async_clock_converter_0/xpm_fifo_async_inst/gnuram_async_fifo.xpm_fifo_base_inst/gen_sdpram.xpm_memory_base_inst/gen_wr_a.gen_word_narrow.mem_reg_0_31_0_5/RAMB_D1/CLK
                            (rising edge-triggered cell RAMD32 clocked by clk_fpga_1  {rise@0.000ns fall@6.499ns period=12.999ns})
  Destination:            system_i/system_i/qr_capture_cdc/inst/gen_async_conv.axisc_async_clock_converter_0/xpm_fifo_async_inst/gnuram_async_fifo.xpm_fifo_base_inst/gen_sdpram.xpm_memory_base_inst/gen_rd_b.gen_rd_b_synth_template.gen_rf_narrow_pipe.doutb_reg_reg[3]/D
                            (rising edge-triggered cell FDRE clocked by clk_fpga_0  {rise@0.000ns fall@5.000ns period=10.000ns})
  Path Group:             clk_fpga_0
  Path Type:              Setup (Max at Slow Process Corner)
  Requirement:            12.999ns  (MaxDelay Path 12.999ns)
  Data Path Delay:        2.473ns  (logic 1.087ns (43.948%)  route 1.386ns (56.052%))
  Logic Levels:           0  
  Timing Exception:       MaxDelay Path 12.999ns -datapath_only

    Location             Delay type                Incr(ns)  Path(ns)    Netlist Resource(s)
  -------------------------------------------------------------------    -------------------
    SLICE_X42Y70                                      0.000     0.000 r  system_i/system_i/qr_capture_cdc/inst/gen_async_conv.axisc_async_clock_converter_0/xpm_fifo_async_inst/gnuram_async_fifo.xpm_fifo_base_inst/gen_sdpram.xpm_memory_base_inst/gen_wr_a.gen_word_narrow.mem_reg_0_31_0_5/RAMB_D1/CLK
    SLICE_X42Y70         RAMD32 (Prop_ramd32_CLK_O)
                                                      1.087     1.087 r  system_i/system_i/qr_capture_cdc/inst/gen_async_conv.axisc_async_clock_converter_0/xpm_fifo_async_inst/gnuram_async_fifo.xpm_fifo_base_inst/gen_sdpram.xpm_memory_base_inst/gen_wr_a.gen_word_narrow.mem_reg_0_31_0_5/RAMB_D1/O
                         net (fo=1, routed)           1.386     2.473    system_i/system_i/qr_capture_cdc/inst/gen_async_conv.axisc_async_clock_converter_0/xpm_fifo_async_inst/gnuram_async_fifo.xpm_fifo_base_inst/gen_sdpram.xpm_memory_base_inst/gen_rd_b.gen_rd_b_synth_template.gen_rf_narrow_pipe.doutb_reg_reg0[3]
    SLICE_X53Y93         FDRE                                         r  system_i/system_i/qr_capture_cdc/inst/gen_async_conv.axisc_async_clock_converter_0/xpm_fifo_async_inst/gnuram_async_fifo.xpm_fifo_base_inst/gen_sdpram.xpm_memory_base_inst/gen_rd_b.gen_rd_b_synth_template.gen_rf_narrow_pipe.doutb_reg_reg[3]/D
  -------------------------------------------------------------------    -------------------

                         max delay                   12.999    12.999    
    SLICE_X53Y93         FDRE (Setup_fdre_C_D)       -0.027    12.972    system_i/system_i/qr_capture_cdc/inst/gen_async_conv.axisc_async_clock_converter_0/xpm_fifo_async_inst/gnuram_async_fifo.xpm_fifo_base_inst/gen_sdpram.xpm_memory_base_inst/gen_rd_b.gen_rd_b_synth_template.gen_rf_narrow_pipe.doutb_reg_reg[3]
  -------------------------------------------------------------------
                         required time                         12.972    
                         arrival time                          -2.473    
  -------------------------------------------------------------------
                         slack                                 10.499    

---------------------------------------------------------------------------------------------------
From Clock:  clk_out1_system_pixel_clock_0
  To Clock:  clk_fpga_0

Setup :            0  Failing Endpoints,  Worst Slack        7.666ns,  Total Violation        0.000ns
Hold  :           NA  Failing Endpoints,  Worst Slack           NA  ,  Total Violation           NA
---------------------------------------------------------------------------------------------------

Max Delay Paths
--------------------------------------------------------------------------------------
Slack (MET) :             7.666ns  (required time - arrival time)
  Source:                 system_i/system_i/display_identity/inst/shown_tag_reg[17]/C
                            (rising edge-triggered cell FDRE clocked by clk_out1_system_pixel_clock_0  {rise@0.000ns fall@6.734ns period=13.468ns})
  Destination:            system_i/system_i/display_identity/inst/scan_tag_reg[17]/D
                            (rising edge-triggered cell FDRE clocked by clk_fpga_0  {rise@0.000ns fall@5.000ns period=10.000ns})
  Path Group:             clk_fpga_0
  Path Type:              Setup (Max at Slow Process Corner)
  Requirement:            9.700ns  (MaxDelay Path 9.700ns)
  Data Path Delay:        1.960ns  (logic 0.433ns (22.095%)  route 1.527ns (77.905%))
  Logic Levels:           0  
  Timing Exception:       MaxDelay Path 9.700ns -datapath_only

    Location             Delay type                Incr(ns)  Path(ns)    Netlist Resource(s)
  -------------------------------------------------------------------    -------------------
    SLICE_X58Y61                                      0.000     0.000 r  system_i/system_i/display_identity/inst/shown_tag_reg[17]/C
    SLICE_X58Y61         FDRE (Prop_fdre_C_Q)         0.433     0.433 r  system_i/system_i/display_identity/inst/shown_tag_reg[17]/Q
                         net (fo=2, routed)           1.527     1.960    system_i/system_i/display_identity/inst/shown_tag[17]
    SLICE_X65Y61         FDRE                                         r  system_i/system_i/display_identity/inst/scan_tag_reg[17]/D
  -------------------------------------------------------------------    -------------------

                         max delay                    9.700     9.700    
    SLICE_X65Y61         FDRE (Setup_fdre_C_D)       -0.074     9.626    system_i/system_i/display_identity/inst/scan_tag_reg[17]
  -------------------------------------------------------------------
                         required time                          9.626    
                         arrival time                          -1.960    
  -------------------------------------------------------------------
                         slack                                  7.666    

---------------------------------------------------------------------------------------------------
From Clock:  cam1_pclk
  To Clock:  clk_fpga_1

Setup :            0  Failing Endpoints,  Worst Slack        6.364ns,  Total Violation        0.000ns
Hold  :           NA  Failing Endpoints,  Worst Slack           NA  ,  Total Violation           NA
---------------------------------------------------------------------------------------------------

Max Delay Paths
--------------------------------------------------------------------------------------
Slack (MET) :             6.364ns  (required time - arrival time)
  Source:                 system_i/system_i/qr_camera_cdc/inst/gen_async_conv.axisc_async_clock_converter_0/xpm_fifo_async_inst/gnuram_async_fifo.xpm_fifo_base_inst/gen_sdpram.xpm_memory_base_inst/gen_wr_a.gen_word_narrow.mem_reg_0_31_36_41/RAMC/CLK
                            (rising edge-triggered cell RAMD32 clocked by cam1_pclk  {rise@0.000ns fall@4.850ns period=9.700ns})
  Destination:            system_i/system_i/qr_camera_cdc/inst/gen_async_conv.axisc_async_clock_converter_0/xpm_fifo_async_inst/gnuram_async_fifo.xpm_fifo_base_inst/gen_sdpram.xpm_memory_base_inst/gen_rd_b.gen_rd_b_synth_template.gen_rf_narrow_pipe.doutb_reg_reg[40]/D
                            (rising edge-triggered cell FDRE clocked by clk_fpga_1  {rise@0.000ns fall@6.499ns period=12.999ns})
  Path Group:             clk_fpga_1
  Path Type:              Setup (Max at Slow Process Corner)
  Requirement:            9.700ns  (MaxDelay Path 9.700ns)
  Data Path Delay:        3.101ns  (logic 1.100ns (35.467%)  route 2.001ns (64.533%))
  Logic Levels:           0  
  Timing Exception:       MaxDelay Path 9.700ns -datapath_only

    Location             Delay type                Incr(ns)  Path(ns)    Netlist Resource(s)
  -------------------------------------------------------------------    -------------------
    SLICE_X82Y53                                      0.000     0.000 r  system_i/system_i/qr_camera_cdc/inst/gen_async_conv.axisc_async_clock_converter_0/xpm_fifo_async_inst/gnuram_async_fifo.xpm_fifo_base_inst/gen_sdpram.xpm_memory_base_inst/gen_wr_a.gen_word_narrow.mem_reg_0_31_36_41/RAMC/CLK
    SLICE_X82Y53         RAMD32 (Prop_ramd32_CLK_O)
                                                      1.100     1.100 r  system_i/system_i/qr_camera_cdc/inst/gen_async_conv.axisc_async_clock_converter_0/xpm_fifo_async_inst/gnuram_async_fifo.xpm_fifo_base_inst/gen_sdpram.xpm_memory_base_inst/gen_wr_a.gen_word_narrow.mem_reg_0_31_36_41/RAMC/O
                         net (fo=1, routed)           2.001     3.101    system_i/system_i/qr_camera_cdc/inst/gen_async_conv.axisc_async_clock_converter_0/xpm_fifo_async_inst/gnuram_async_fifo.xpm_fifo_base_inst/gen_sdpram.xpm_memory_base_inst/gen_rd_b.gen_rd_b_synth_template.gen_rf_narrow_pipe.doutb_reg_reg0[40]
    SLICE_X65Y28         FDRE                                         r  system_i/system_i/qr_camera_cdc/inst/gen_async_conv.axisc_async_clock_converter_0/xpm_fifo_async_inst/gnuram_async_fifo.xpm_fifo_base_inst/gen_sdpram.xpm_memory_base_inst/gen_rd_b.gen_rd_b_synth_template.gen_rf_narrow_pipe.doutb_reg_reg[40]/D
  -------------------------------------------------------------------    -------------------

                         max delay                    9.700     9.700    
    SLICE_X65Y28         FDRE (Setup_fdre_C_D)       -0.235     9.465    system_i/system_i/qr_camera_cdc/inst/gen_async_conv.axisc_async_clock_converter_0/xpm_fifo_async_inst/gnuram_async_fifo.xpm_fifo_base_inst/gen_sdpram.xpm_memory_base_inst/gen_rd_b.gen_rd_b_synth_template.gen_rf_narrow_pipe.doutb_reg_reg[40]
  -------------------------------------------------------------------
                         required time                          9.465    
                         arrival time                          -3.101    
  -------------------------------------------------------------------
                         slack                                  6.364    

---------------------------------------------------------------------------------------------------
From Clock:  clk_fpga_0
  To Clock:  clk_fpga_1

Setup :            0  Failing Endpoints,  Worst Slack        8.691ns,  Total Violation        0.000ns
Hold  :           NA  Failing Endpoints,  Worst Slack           NA  ,  Total Violation           NA
---------------------------------------------------------------------------------------------------

Max Delay Paths
--------------------------------------------------------------------------------------
Slack (MET) :             8.691ns  (required time - arrival time)
  Source:                 system_i/system_i/qr_capture_cdc/inst/gen_async_conv.axisc_async_clock_converter_0/xpm_fifo_async_inst/gnuram_async_fifo.xpm_fifo_base_inst/gen_cdc_pntr.rd_pntr_cdc_inst/src_gray_ff_reg[1]/C
                            (rising edge-triggered cell FDRE clocked by clk_fpga_0  {rise@0.000ns fall@5.000ns period=10.000ns})
  Destination:            system_i/system_i/qr_capture_cdc/inst/gen_async_conv.axisc_async_clock_converter_0/xpm_fifo_async_inst/gnuram_async_fifo.xpm_fifo_base_inst/gen_cdc_pntr.rd_pntr_cdc_inst/dest_graysync_ff_reg[0][1]/D
                            (rising edge-triggered cell FDRE clocked by clk_fpga_1  {rise@0.000ns fall@6.499ns period=12.999ns})
  Path Group:             clk_fpga_1
  Path Type:              Setup (Max at Slow Process Corner)
  Requirement:            10.000ns  (MaxDelay Path 10.000ns)
  Data Path Delay:        1.109ns  (logic 0.398ns (35.903%)  route 0.711ns (64.097%))
  Logic Levels:           0  
  Timing Exception:       MaxDelay Path 10.000ns -datapath_only

    Location             Delay type                Incr(ns)  Path(ns)    Netlist Resource(s)
  -------------------------------------------------------------------    -------------------
    SLICE_X54Y74                                      0.000     0.000 r  system_i/system_i/qr_capture_cdc/inst/gen_async_conv.axisc_async_clock_converter_0/xpm_fifo_async_inst/gnuram_async_fifo.xpm_fifo_base_inst/gen_cdc_pntr.rd_pntr_cdc_inst/src_gray_ff_reg[1]/C
    SLICE_X54Y74         FDRE (Prop_fdre_C_Q)         0.398     0.398 r  system_i/system_i/qr_capture_cdc/inst/gen_async_conv.axisc_async_clock_converter_0/xpm_fifo_async_inst/gnuram_async_fifo.xpm_fifo_base_inst/gen_cdc_pntr.rd_pntr_cdc_inst/src_gray_ff_reg[1]/Q
                         net (fo=1, routed)           0.711     1.109    system_i/system_i/qr_capture_cdc/inst/gen_async_conv.axisc_async_clock_converter_0/xpm_fifo_async_inst/gnuram_async_fifo.xpm_fifo_base_inst/gen_cdc_pntr.rd_pntr_cdc_inst/async_path[1]
    SLICE_X60Y84         FDRE                                         r  system_i/system_i/qr_capture_cdc/inst/gen_async_conv.axisc_async_clock_converter_0/xpm_fifo_async_inst/gnuram_async_fifo.xpm_fifo_base_inst/gen_cdc_pntr.rd_pntr_cdc_inst/dest_graysync_ff_reg[0][1]/D
  -------------------------------------------------------------------    -------------------

                         max delay                   10.000    10.000    
    SLICE_X60Y84         FDRE (Setup_fdre_C_D)       -0.200     9.800    system_i/system_i/qr_capture_cdc/inst/gen_async_conv.axisc_async_clock_converter_0/xpm_fifo_async_inst/gnuram_async_fifo.xpm_fifo_base_inst/gen_cdc_pntr.rd_pntr_cdc_inst/dest_graysync_ff_reg[0][1]
  -------------------------------------------------------------------
                         required time                          9.800    
                         arrival time                          -1.109    
  -------------------------------------------------------------------
                         slack                                  8.691    

---------------------------------------------------------------------------------------------------
From Clock:  cam1_pclk
  To Clock:  clk_out1_system_pixel_clock_0

Setup :            0  Failing Endpoints,  Worst Slack        7.865ns,  Total Violation        0.000ns
Hold  :           NA  Failing Endpoints,  Worst Slack           NA  ,  Total Violation           NA
---------------------------------------------------------------------------------------------------

Max Delay Paths
--------------------------------------------------------------------------------------
Slack (MET) :             7.865ns  (required time - arrival time)
  Source:                 fork_i/display/fault_reg/C
                            (rising edge-triggered cell FDRE clocked by cam1_pclk  {rise@0.000ns fall@4.850ns period=9.700ns})
  Destination:            system_i/system_i/display_osd/inst/fault0_reg/D
                            (rising edge-triggered cell FDRE clocked by clk_out1_system_pixel_clock_0  {rise@0.000ns fall@6.734ns period=13.468ns})
  Path Group:             clk_out1_system_pixel_clock_0
  Path Type:              Setup (Max at Slow Process Corner)
  Requirement:            9.700ns  (MaxDelay Path 9.700ns)
  Data Path Delay:        1.760ns  (logic 0.484ns (27.497%)  route 1.276ns (72.503%))
  Logic Levels:           1  (LUT2=1)
  Timing Exception:       MaxDelay Path 9.700ns -datapath_only

    Location             Delay type                Incr(ns)  Path(ns)    Netlist Resource(s)
  -------------------------------------------------------------------    -------------------
    SLICE_X44Y56                                      0.000     0.000 r  fork_i/display/fault_reg/C
    SLICE_X44Y56         FDRE (Prop_fdre_C_Q)         0.379     0.379 r  fork_i/display/fault_reg/Q
                         net (fo=6, routed)           1.018     1.397    system_i/system_i/display_osd/inst/display_fault
    SLICE_X46Y63         LUT2 (Prop_lut2_I1_O)        0.105     1.502 r  system_i/system_i/display_osd/inst/fault0_i_1/O
                         net (fo=1, routed)           0.258     1.760    system_i/system_i/display_osd/inst/fault0_reg0
    SLICE_X47Y63         FDRE                                         r  system_i/system_i/display_osd/inst/fault0_reg/D
  -------------------------------------------------------------------    -------------------

                         max delay                    9.700     9.700    
    SLICE_X47Y63         FDRE (Setup_fdre_C_D)       -0.075     9.625    system_i/system_i/display_osd/inst/fault0_reg
  -------------------------------------------------------------------
                         required time                          9.625    
                         arrival time                          -1.760    
  -------------------------------------------------------------------
                         slack                                  7.865    

---------------------------------------------------------------------------------------------------
From Clock:  clk_fpga_0
  To Clock:  clk_out1_system_pixel_clock_0

Setup :            0  Failing Endpoints,  Worst Slack        6.564ns,  Total Violation        0.000ns
Hold  :           NA  Failing Endpoints,  Worst Slack           NA  ,  Total Violation           NA
---------------------------------------------------------------------------------------------------

Max Delay Paths
--------------------------------------------------------------------------------------
Slack (MET) :             6.564ns  (required time - arrival time)
  Source:                 system_i/system_i/display_identity/inst/rf1_reg/C
                            (rising edge-triggered cell FDRE clocked by clk_fpga_0  {rise@0.000ns fall@5.000ns period=10.000ns})
  Destination:            system_i/system_i/display_osd/inst/fault0_reg/D
                            (rising edge-triggered cell FDRE clocked by clk_out1_system_pixel_clock_0  {rise@0.000ns fall@6.734ns period=13.468ns})
  Path Group:             clk_out1_system_pixel_clock_0
  Path Type:              Setup (Max at Slow Process Corner)
  Requirement:            9.700ns  (MaxDelay Path 9.700ns)
  Data Path Delay:        3.061ns  (logic 0.797ns (26.040%)  route 2.264ns (73.960%))
  Logic Levels:           3  (LUT2=3)
  Timing Exception:       MaxDelay Path 9.700ns -datapath_only

    Location             Delay type                Incr(ns)  Path(ns)    Netlist Resource(s)
  -------------------------------------------------------------------    -------------------
    SLICE_X45Y64                                      0.000     0.000 r  system_i/system_i/display_identity/inst/rf1_reg/C
    SLICE_X45Y64         FDRE (Prop_fdre_C_Q)         0.348     0.348 r  system_i/system_i/display_identity/inst/rf1_reg/Q
                         net (fo=1, routed)           0.519     0.867    system_i/system_i/display_identity/inst/rf1
    SLICE_X45Y62         LUT2 (Prop_lut2_I1_O)        0.239     1.106 r  system_i/system_i/display_identity/inst/fault_INST_0/O
                         net (fo=1, routed)           0.672     1.778    system_i/system_i/display_fault_or/Op2[0]
    SLICE_X48Y62         LUT2 (Prop_lut2_I1_O)        0.105     1.883 r  system_i/system_i/display_fault_or/Res[0]_INST_0/O
                         net (fo=2, routed)           0.814     2.697    system_i/system_i/display_osd/inst/memory_fault
    SLICE_X46Y63         LUT2 (Prop_lut2_I0_O)        0.105     2.802 r  system_i/system_i/display_osd/inst/fault0_i_1/O
                         net (fo=1, routed)           0.258     3.061    system_i/system_i/display_osd/inst/fault0_reg0
    SLICE_X47Y63         FDRE                                         r  system_i/system_i/display_osd/inst/fault0_reg/D
  -------------------------------------------------------------------    -------------------

                         max delay                    9.700     9.700    
    SLICE_X47Y63         FDRE (Setup_fdre_C_D)       -0.075     9.625    system_i/system_i/display_osd/inst/fault0_reg
  -------------------------------------------------------------------
                         required time                          9.625    
                         arrival time                          -3.061    
  -------------------------------------------------------------------
                         slack                                  6.564    

---------------------------------------------------------------------------------------------------
From Clock:  clk_out1_system_pixel_clock_0
  To Clock:  hdmi_forwarded

Setup :            0  Failing Endpoints,  Worst Slack        0.405ns,  Total Violation        0.000ns
Hold  :            0  Failing Endpoints,  Worst Slack        6.184ns,  Total Violation        0.000ns
---------------------------------------------------------------------------------------------------

Max Delay Paths
--------------------------------------------------------------------------------------
Slack (MET) :             0.405ns  (required time - arrival time)
  Source:                 system_i/system_i/display_osd/inst/out_rgb_reg[5]/C
                            (rising edge-triggered cell FDRE clocked by clk_out1_system_pixel_clock_0  {rise@0.000ns fall@6.734ns period=13.468ns})
  Destination:            hdmi_d[10]
                            (output port clocked by hdmi_forwarded  {rise@6.734ns fall@13.468ns period=13.468ns})
  Path Group:             hdmi_forwarded
  Path Type:              Max at Slow Process Corner
  Requirement:            6.734ns  (hdmi_forwarded rise@6.734ns - clk_out1_system_pixel_clock_0 rise@0.000ns)
  Data Path Delay:        7.285ns  (logic 3.285ns (45.088%)  route 4.000ns (54.912%))
  Logic Levels:           1  (OBUF=1)
  Output Delay:           2.000ns
  Clock Path Skew:        3.084ns (DCD - SCD + CPR)
    Destination Clock Delay (DCD):    4.466ns = ( 11.200 - 6.734 ) 
    Source Clock Delay      (SCD):    1.394ns
    Clock Pessimism Removal (CPR):    0.012ns
  Clock Uncertainty:      0.128ns  ((TSJ^2 + DJ^2)^1/2) / 2 + PE
    Total System Jitter     (TSJ):    0.071ns
    Discrete Jitter          (DJ):    0.245ns
    Phase Error              (PE):    0.000ns

    Location             Delay type                Incr(ns)  Path(ns)    Netlist Resource(s)
  -------------------------------------------------------------------    -------------------
                         (clock clk_out1_system_pixel_clock_0 rise edge)
                                                      0.000     0.000 r  
    BUFGCTRL_X0Y16       BUFG                         0.000     0.000 r  system_i/system_i/ps7/inst/buffer_fclk_clk_0.FCLK_CLK_0_BUFG/O
                         net (fo=28349, routed)       1.552     1.552    system_i/system_i/pixel_clock/inst/clk_in1
    MMCME2_ADV_X1Y0      MMCME2_ADV (Prop_mmcme2_adv_CLKIN1_CLKOUT0)
                                                     -3.232    -1.680 r  system_i/system_i/pixel_clock/inst/mmcm_adv_inst/CLKOUT0
                         net (fo=1, routed)           1.597    -0.083    system_i/system_i/pixel_clock/inst/clk_out1_system_pixel_clock_0
    BUFGCTRL_X0Y0        BUFG (Prop_bufg_I_O)         0.085     0.002 r  system_i/system_i/pixel_clock/inst/clkout1_buf/O
                         net (fo=1043, routed)        1.392     1.394    system_i/system_i/display_osd/inst/pixel_clk
    SLICE_X43Y55         FDRE                                         r  system_i/system_i/display_osd/inst/out_rgb_reg[5]/C
  -------------------------------------------------------------------    -------------------
    SLICE_X43Y55         FDRE (Prop_fdre_C_Q)         0.379     1.773 r  system_i/system_i/display_osd/inst/out_rgb_reg[5]/Q
                         net (fo=1, routed)           4.000     5.773    hdmi_d_OBUF[10]
    H18                  OBUF (Prop_obuf_I_O)         2.906     8.679 r  hdmi_d_OBUF[10]_inst/O
                         net (fo=0)                   0.000     8.679    hdmi_d[10]
    H18                                                               r  hdmi_d[10] (OUT)
  -------------------------------------------------------------------    -------------------

                         (clock hdmi_forwarded rise edge)
                                                      6.734     6.734 r  
    BUFGCTRL_X0Y16       BUFG                         0.000     6.734 r  system_i/system_i/ps7/inst/buffer_fclk_clk_0.FCLK_CLK_0_BUFG/O
                         net (fo=28349, routed)       1.386     8.120    system_i/system_i/pixel_clock/inst/clk_in1
    MMCME2_ADV_X1Y0      MMCME2_ADV (Prop_mmcme2_adv_CLKIN1_CLKOUT0)
                                                     -2.915     5.205 r  system_i/system_i/pixel_clock/inst/mmcm_adv_inst/CLKOUT0
                         net (fo=1, routed)           1.454     6.659    system_i/system_i/pixel_clock/inst/clk_out1_system_pixel_clock_0
    BUFGCTRL_X0Y0        BUFG (Prop_bufg_I_O)         0.077     6.736 r  system_i/system_i/pixel_clock/inst/clkout1_buf/O
                         net (fo=1043, routed)        1.553     8.289    system_i/system_i/video_timing/inst/pixel_clk
    OLOGIC_X1Y141        ODDR (Prop_oddr_C_Q)         0.363     8.652 r  system_i/system_i/video_timing/inst/clock_out/Q
                         net (fo=1, routed)           0.001     8.653    hdmi_clk_OBUF
    G16                  OBUF (Prop_obuf_I_O)         2.547    11.200 r  hdmi_clk_OBUF_inst/O
                         net (fo=0)                   0.000    11.200    hdmi_clk
    G16                                                               r  hdmi_clk (OUT)
                         clock pessimism              0.012    11.212    
                         clock uncertainty           -0.128    11.084    
                         output delay                -2.000     9.084    
  -------------------------------------------------------------------
                         required time                          9.084    
                         arrival time                          -8.679    
  -------------------------------------------------------------------
                         slack                                  0.405    

Min Delay Paths
--------------------------------------------------------------------------------------
Slack (MET) :             6.184ns  (arrival time - required time)
  Source:                 system_i/system_i/display_osd/inst/out_de_reg/C
                            (rising edge-triggered cell FDRE clocked by clk_out1_system_pixel_clock_0  {rise@0.000ns fall@6.734ns period=13.468ns})
  Destination:            hdmi_de
                            (output port clocked by hdmi_forwarded  {rise@6.734ns fall@13.468ns period=13.468ns})
  Path Group:             hdmi_forwarded
  Path Type:              Min at Fast Process Corner
  Requirement:            -6.734ns  (hdmi_forwarded rise@6.734ns - clk_out1_system_pixel_clock_0 rise@13.468ns)
  Data Path Delay:        1.646ns  (logic 1.322ns (80.301%)  route 0.324ns (19.699%))
  Logic Levels:           1  (OBUF=1)
  Output Delay:           -0.500ns
  Clock Path Skew:        1.568ns (DCD - SCD - CPR)
    Destination Clock Delay (DCD):    2.527ns = ( 9.261 - 6.734 ) 
    Source Clock Delay      (SCD):    0.721ns = ( 14.189 - 13.468 ) 
    Clock Pessimism Removal (CPR):    0.238ns
  Clock Uncertainty:      0.128ns  ((TSJ^2 + DJ^2)^1/2) / 2 + PE
    Total System Jitter     (TSJ):    0.071ns
    Discrete Jitter          (DJ):    0.245ns
    Phase Error              (PE):    0.000ns

    Location             Delay type                Incr(ns)  Path(ns)    Netlist Resource(s)
  -------------------------------------------------------------------    -------------------
                         (clock clk_out1_system_pixel_clock_0 rise edge)
                                                     13.468    13.468 r  
    BUFGCTRL_X0Y16       BUFG                         0.000    13.468 r  system_i/system_i/ps7/inst/buffer_fclk_clk_0.FCLK_CLK_0_BUFG/O
                         net (fo=28349, routed)       0.597    14.065    system_i/system_i/pixel_clock/inst/clk_in1
    MMCME2_ADV_X1Y0      MMCME2_ADV (Prop_mmcme2_adv_CLKIN1_CLKOUT0)
                                                     -1.150    12.915 r  system_i/system_i/pixel_clock/inst/mmcm_adv_inst/CLKOUT0
                         net (fo=1, routed)           0.529    13.444    system_i/system_i/pixel_clock/inst/clk_out1_system_pixel_clock_0
    BUFGCTRL_X0Y0        BUFG (Prop_bufg_I_O)         0.026    13.470 r  system_i/system_i/pixel_clock/inst/clkout1_buf/O
                         net (fo=1043, routed)        0.719    14.189    system_i/system_i/display_osd/inst/pixel_clk
    SLICE_X113Y107       FDRE                                         r  system_i/system_i/display_osd/inst/out_de_reg/C
  -------------------------------------------------------------------    -------------------
    SLICE_X113Y107       FDRE (Prop_fdre_C_Q)         0.141    14.330 r  system_i/system_i/display_osd/inst/out_de_reg/Q
                         net (fo=1, routed)           0.324    14.654    hdmi_de_OBUF
    E20                  OBUF (Prop_obuf_I_O)         1.181    15.835 r  hdmi_de_OBUF_inst/O
                         net (fo=0)                   0.000    15.835    hdmi_de
    E20                                                               r  hdmi_de (OUT)
  -------------------------------------------------------------------    -------------------

                         (clock hdmi_forwarded rise edge)
                                                      6.734     6.734 r  
    BUFGCTRL_X0Y16       BUFG                         0.000     6.734 r  system_i/system_i/ps7/inst/buffer_fclk_clk_0.FCLK_CLK_0_BUFG/O
                         net (fo=28349, routed)       0.864     7.598    system_i/system_i/pixel_clock/inst/clk_in1
    MMCME2_ADV_X1Y0      MMCME2_ADV (Prop_mmcme2_adv_CLKIN1_CLKOUT0)
                                                     -1.467     6.131 r  system_i/system_i/pixel_clock/inst/mmcm_adv_inst/CLKOUT0
                         net (fo=1, routed)           0.576     6.707    system_i/system_i/pixel_clock/inst/clk_out1_system_pixel_clock_0
    BUFGCTRL_X0Y0        BUFG (Prop_bufg_I_O)         0.029     6.736 r  system_i/system_i/pixel_clock/inst/clkout1_buf/O
                         net (fo=1043, routed)        0.988     7.724    system_i/system_i/video_timing/inst/pixel_clk
    OLOGIC_X1Y141        ODDR (Prop_oddr_C_Q)         0.204     7.928 r  system_i/system_i/video_timing/inst/clock_out/Q
                         net (fo=1, routed)           0.001     7.929    hdmi_clk_OBUF
    G16                  OBUF (Prop_obuf_I_O)         1.332     9.261 r  hdmi_clk_OBUF_inst/O
                         net (fo=0)                   0.000     9.261    hdmi_clk
    G16                                                               r  hdmi_clk (OUT)
                         clock pessimism             -0.238     9.023    
                         clock uncertainty            0.128     9.151    
                         output delay                 0.500     9.651    
  -------------------------------------------------------------------
                         required time                         -9.651    
                         arrival time                          15.835    
  -------------------------------------------------------------------
                         slack                                  6.184    

---------------------------------------------------------------------------------------------------
Path Group:  **async_default**
From Clock:  cam1_pclk
  To Clock:  cam1_pclk

Setup :            0  Failing Endpoints,  Worst Slack        4.892ns,  Total Violation        0.000ns
Hold  :            0  Failing Endpoints,  Worst Slack        0.678ns,  Total Violation        0.000ns
---------------------------------------------------------------------------------------------------

Max Delay Paths
--------------------------------------------------------------------------------------
Slack (MET) :             4.892ns  (required time - arrival time)
  Source:                 camera_reset_sync_reg[1]/C
                            (rising edge-triggered cell FDCE clocked by cam1_pclk  {rise@0.000ns fall@4.850ns period=9.700ns})
  Destination:            gate_i/line_count_reg[2]/CLR
                            (recovery check against rising-edge clock cam1_pclk  {rise@0.000ns fall@4.850ns period=9.700ns})
  Path Group:             **async_default**
  Path Type:              Recovery (Max at Slow Process Corner)
  Requirement:            9.700ns  (cam1_pclk rise@9.700ns - cam1_pclk rise@0.000ns)
  Data Path Delay:        4.401ns  (logic 0.484ns (10.998%)  route 3.917ns (89.002%))
  Logic Levels:           1  (LUT1=1)
  Clock Path Skew:        -0.041ns (DCD - SCD + CPR)
    Destination Clock Delay (DCD):    4.589ns = ( 14.289 - 9.700 ) 
    Source Clock Delay      (SCD):    5.113ns
    Clock Pessimism Removal (CPR):    0.483ns
  Clock Uncertainty:      0.035ns  ((TSJ^2 + TIJ^2)^1/2 + DJ) / 2 + PE
    Total System Jitter     (TSJ):    0.071ns
    Total Input Jitter      (TIJ):    0.000ns
    Discrete Jitter          (DJ):    0.000ns
    Phase Error              (PE):    0.000ns

    Location             Delay type                Incr(ns)  Path(ns)    Netlist Resource(s)
  -------------------------------------------------------------------    -------------------
                         (clock cam1_pclk rise edge)
                                                      0.000     0.000 r  
    AB9                                               0.000     0.000 r  cam1_pclk (IN)
                         net (fo=0)                   0.000     0.000    cam1_pclk
    AB9                  IBUF (Prop_ibuf_I_O)         1.448     1.448 r  cam1_pclk_IBUF_inst/O
                         net (fo=1, routed)           2.207     3.655    cam1_pclk_IBUF
    BUFGCTRL_X0Y1        BUFG (Prop_bufg_I_O)         0.085     3.740 r  cam1_pclk_IBUF_BUFG_inst/O
                         net (fo=1460, routed)        1.373     5.113    cam1_pclk_IBUF_BUFG
    SLICE_X40Y74         FDCE                                         r  camera_reset_sync_reg[1]/C
  -------------------------------------------------------------------    -------------------
    SLICE_X40Y74         FDCE (Prop_fdce_C_Q)         0.379     5.492 r  camera_reset_sync_reg[1]/Q
                         net (fo=40, routed)          0.794     6.286    fork_i/display/completed_reg[0]_0[0]
    SLICE_X53Y74         LUT1 (Prop_lut1_I0_O)        0.105     6.391 f  fork_i/display/FSM_sequential_state[1]_i_2/O
                         net (fo=457, routed)         3.123     9.514    gate_i/FSM_sequential_state_reg[0]_0[0]
    SLICE_X47Y51         FDCE                                         f  gate_i/line_count_reg[2]/CLR
  -------------------------------------------------------------------    -------------------

                         (clock cam1_pclk rise edge)
                                                      9.700     9.700 r  
    AB9                                               0.000     9.700 r  cam1_pclk (IN)
                         net (fo=0)                   0.000     9.700    cam1_pclk
    AB9                  IBUF (Prop_ibuf_I_O)         1.382    11.082 r  cam1_pclk_IBUF_inst/O
                         net (fo=1, routed)           1.894    12.976    cam1_pclk_IBUF
    BUFGCTRL_X0Y1        BUFG (Prop_bufg_I_O)         0.077    13.053 r  cam1_pclk_IBUF_BUFG_inst/O
                         net (fo=1460, routed)        1.236    14.289    gate_i/cam1_pclk_IBUF_BUFG
    SLICE_X47Y51         FDCE                                         r  gate_i/line_count_reg[2]/C
                         clock pessimism              0.483    14.772    
                         clock uncertainty           -0.035    14.737    
    SLICE_X47Y51         FDCE (Recov_fdce_C_CLR)     -0.331    14.406    gate_i/line_count_reg[2]
  -------------------------------------------------------------------
                         required time                         14.406    
                         arrival time                          -9.514    
  -------------------------------------------------------------------
                         slack                                  4.892    

Min Delay Paths
--------------------------------------------------------------------------------------
Slack (MET) :             0.678ns  (arrival time - required time)
  Source:                 camera_reset_sync_reg[1]/C
                            (rising edge-triggered cell FDCE clocked by cam1_pclk  {rise@0.000ns fall@4.850ns period=9.700ns})
  Destination:            gate_i/arm_sync_reg[0]/CLR
                            (removal check against rising-edge clock cam1_pclk  {rise@0.000ns fall@4.850ns period=9.700ns})
  Path Group:             **async_default**
  Path Type:              Removal (Min at Fast Process Corner)
  Requirement:            0.000ns  (cam1_pclk rise@0.000ns - cam1_pclk rise@0.000ns)
  Data Path Delay:        0.898ns  (logic 0.186ns (20.721%)  route 0.712ns (79.279%))
  Logic Levels:           1  (LUT1=1)
  Clock Path Skew:        0.286ns (DCD - SCD - CPR)
    Destination Clock Delay (DCD):    2.633ns
    Source Clock Delay      (SCD):    1.982ns
    Clock Pessimism Removal (CPR):    0.365ns

    Location             Delay type                Incr(ns)  Path(ns)    Netlist Resource(s)
  -------------------------------------------------------------------    -------------------
                         (clock cam1_pclk rise edge)
                                                      0.000     0.000 r  
    AB9                                               0.000     0.000 r  cam1_pclk (IN)
                         net (fo=0)                   0.000     0.000    cam1_pclk
    AB9                  IBUF (Prop_ibuf_I_O)         0.285     0.285 r  cam1_pclk_IBUF_inst/O
                         net (fo=1, routed)           1.126     1.411    cam1_pclk_IBUF
    BUFGCTRL_X0Y1        BUFG (Prop_bufg_I_O)         0.026     1.437 r  cam1_pclk_IBUF_BUFG_inst/O
                         net (fo=1460, routed)        0.545     1.982    cam1_pclk_IBUF_BUFG
    SLICE_X40Y74         FDCE                                         r  camera_reset_sync_reg[1]/C
  -------------------------------------------------------------------    -------------------
    SLICE_X40Y74         FDCE (Prop_fdce_C_Q)         0.141     2.123 r  camera_reset_sync_reg[1]/Q
                         net (fo=40, routed)          0.355     2.477    fork_i/display/completed_reg[0]_0[0]
    SLICE_X53Y74         LUT1 (Prop_lut1_I0_O)        0.045     2.522 f  fork_i/display/FSM_sequential_state[1]_i_2/O
                         net (fo=457, routed)         0.357     2.879    gate_i/FSM_sequential_state_reg[0]_0[0]
    SLICE_X58Y72         FDCE                                         f  gate_i/arm_sync_reg[0]/CLR
  -------------------------------------------------------------------    -------------------

                         (clock cam1_pclk rise edge)
                                                      0.000     0.000 r  
    AB9                                               0.000     0.000 r  cam1_pclk (IN)
                         net (fo=0)                   0.000     0.000    cam1_pclk
    AB9                  IBUF (Prop_ibuf_I_O)         0.473     0.473 r  cam1_pclk_IBUF_inst/O
                         net (fo=1, routed)           1.295     1.768    cam1_pclk_IBUF
    BUFGCTRL_X0Y1        BUFG (Prop_bufg_I_O)         0.029     1.797 r  cam1_pclk_IBUF_BUFG_inst/O
                         net (fo=1460, routed)        0.836     2.633    gate_i/cam1_pclk_IBUF_BUFG
    SLICE_X58Y72         FDCE                                         r  gate_i/arm_sync_reg[0]/C
                         clock pessimism             -0.365     2.268    
    SLICE_X58Y72         FDCE (Remov_fdce_C_CLR)     -0.067     2.201    gate_i/arm_sync_reg[0]
  -------------------------------------------------------------------
                         required time                         -2.201    
                         arrival time                           2.879    
  -------------------------------------------------------------------
                         slack                                  0.678    

---------------------------------------------------------------------------------------------------
Path Group:  **async_default**
From Clock:  clk_fpga_0
  To Clock:  clk_fpga_0

Setup :            0  Failing Endpoints,  Worst Slack        5.903ns,  Total Violation        0.000ns
Hold  :            0  Failing Endpoints,  Worst Slack        0.598ns,  Total Violation        0.000ns
---------------------------------------------------------------------------------------------------

Max Delay Paths
--------------------------------------------------------------------------------------
Slack (MET) :             5.903ns  (required time - arrival time)
  Source:                 qr_desktop_top/system_wrapper/system/system_fitness_memory_0/s00_couplers_imp_1QRQH4L/system_fitness_memory_imp_auto_pc_0/system_fitness_memory_imp_auto_pc_0_axi_protocol_converter_v2_1_37_axi_protocol_converter/system_fitness_memory_imp_auto_pc_0_axi_protocol_converter_v2_1_37_axi3_conv/system_fitness_memory_imp_auto_pc_0_axi_protocol_converter_v2_1_37_a_axi3_conv/system_fitness_memory_imp_auto_pc_0_axi_data_fifo_v2_1_36_axic_fifo/system_fitness_memory_imp_auto_pc_0_axi_data_fifo_v2_1_36_fifo_gen/<hidden>/<hidden>/<hidden>/<hidden>/<hidden>/<hidden>
                            (rising edge-triggered cell FDPE clocked by clk_fpga_0  {rise@0.000ns fall@5.000ns period=10.000ns})
  Destination:            qr_desktop_top/system_wrapper/system/system_fitness_memory_0/s00_couplers_imp_1QRQH4L/system_fitness_memory_imp_auto_pc_0/system_fitness_memory_imp_auto_pc_0_axi_protocol_converter_v2_1_37_axi_protocol_converter/system_fitness_memory_imp_auto_pc_0_axi_protocol_converter_v2_1_37_axi3_conv/system_fitness_memory_imp_auto_pc_0_axi_protocol_converter_v2_1_37_a_axi3_conv/system_fitness_memory_imp_auto_pc_0_axi_data_fifo_v2_1_36_axic_fifo/system_fitness_memory_imp_auto_pc_0_axi_data_fifo_v2_1_36_fifo_gen/<hidden>/<hidden>/<hidden>/<hidden>/<hidden>/<hidden>
                            (recovery check against rising-edge clock clk_fpga_0  {rise@0.000ns fall@5.000ns period=10.000ns})
  Path Group:             **async_default**
  Path Type:              Recovery (Max at Slow Process Corner)
  Requirement:            10.000ns  (clk_fpga_0 rise@10.000ns - clk_fpga_0 rise@0.000ns)
  Data Path Delay:        3.592ns  (logic 0.630ns (17.538%)  route 2.962ns (82.462%))
  Logic Levels:           1  (LUT3=1)
  Clock Path Skew:        -0.020ns (DCD - SCD + CPR)
    Destination Clock Delay (DCD):    2.409ns = ( 12.409 - 10.000 ) 
    Source Clock Delay      (SCD):    2.669ns
    Clock Pessimism Removal (CPR):    0.240ns
  Clock Uncertainty:      0.154ns  ((TSJ^2 + TIJ^2)^1/2 + DJ) / 2 + PE
    Total System Jitter     (TSJ):    0.071ns
    Total Input Jitter      (TIJ):    0.300ns
    Discrete Jitter          (DJ):    0.000ns
    Phase Error              (PE):    0.000ns

    Location             Delay type                Incr(ns)  Path(ns)    Netlist Resource(s)
  -------------------------------------------------------------------    -------------------
                         (clock clk_fpga_0 rise edge)
                                                      0.000     0.000 r  
    PS7_X0Y0             PS7                          0.000     0.000 r  system_i/system_i/ps7/inst/PS7_i/FCLKCLK[0]
                         net (fo=1, routed)           0.994     0.994    system_i/system_i/ps7/inst/FCLK_CLK_unbuffered[0]
    BUFGCTRL_X0Y16       BUFG (Prop_bufg_I_O)         0.085     1.079 r  system_i/system_i/ps7/inst/buffer_fclk_clk_0.FCLK_CLK_0_BUFG/O
                         net (fo=28349, routed)       1.590     2.669    qr_desktop_top/system_wrapper/system/system_fitness_memory_0/s00_couplers_imp_1QRQH4L/system_fitness_memory_imp_auto_pc_0/system_fitness_memory_imp_auto_pc_0_axi_protocol_converter_v2_1_37_axi_protocol_converter/system_fitness_memory_imp_auto_pc_0_axi_protocol_converter_v2_1_37_axi3_conv/system_fitness_memory_imp_auto_pc_0_axi_protocol_converter_v2_1_37_a_axi3_conv/system_fitness_memory_imp_auto_pc_0_axi_data_fifo_v2_1_36_axic_fifo/system_fitness_memory_imp_auto_pc_0_axi_data_fifo_v2_1_36_fifo_gen/<hidden>/<hidden>/<hidden>/<hidden>/<hidden>/<hidden>
    SLICE_X26Y115        FDPE                                         r  qr_desktop_top/system_wrapper/system/system_fitness_memory_0/s00_couplers_imp_1QRQH4L/system_fitness_memory_imp_auto_pc_0/system_fitness_memory_imp_auto_pc_0_axi_protocol_converter_v2_1_37_axi_protocol_converter/system_fitness_memory_imp_auto_pc_0_axi_protocol_converter_v2_1_37_axi3_conv/system_fitness_memory_imp_auto_pc_0_axi_protocol_converter_v2_1_37_a_axi3_conv/system_fitness_memory_imp_auto_pc_0_axi_data_fifo_v2_1_36_axic_fifo/system_fitness_memory_imp_auto_pc_0_axi_data_fifo_v2_1_36_fifo_gen/<hidden>/<hidden>/<hidden>/<hidden>/<hidden>/<hidden>
  -------------------------------------------------------------------    -------------------
    SLICE_X26Y115        FDPE (Prop_fdpe_C_Q)         0.398     3.067 f  qr_desktop_top/system_wrapper/system/system_fitness_memory_0/s00_couplers_imp_1QRQH4L/system_fitness_memory_imp_auto_pc_0/system_fitness_memory_imp_auto_pc_0_axi_protocol_converter_v2_1_37_axi_protocol_converter/system_fitness_memory_imp_auto_pc_0_axi_protocol_converter_v2_1_37_axi3_conv/system_fitness_memory_imp_auto_pc_0_axi_protocol_converter_v2_1_37_a_axi3_conv/system_fitness_memory_imp_auto_pc_0_axi_data_fifo_v2_1_36_axic_fifo/system_fitness_memory_imp_auto_pc_0_axi_data_fifo_v2_1_36_fifo_gen/<hidden>/<hidden>/<hidden>/<hidden>/<hidden>/<hidden>
                         net (fo=2, routed)           0.841     3.908    qr_desktop_top/system_wrapper/system/system_fitness_memory_0/s00_couplers_imp_1QRQH4L/system_fitness_memory_imp_auto_pc_0/system_fitness_memory_imp_auto_pc_0_axi_protocol_converter_v2_1_37_axi_protocol_converter/system_fitness_memory_imp_auto_pc_0_axi_protocol_converter_v2_1_37_axi3_conv/system_fitness_memory_imp_auto_pc_0_axi_protocol_converter_v2_1_37_a_axi3_conv/system_fitness_memory_imp_auto_pc_0_axi_data_fifo_v2_1_36_axic_fifo/system_fitness_memory_imp_auto_pc_0_axi_data_fifo_v2_1_36_fifo_gen/<hidden>/<hidden>/<hidden>/<hidden>/<hidden>
    SLICE_X30Y112        LUT3 (Prop_lut3_I2_O)        0.232     4.140 f  qr_desktop_top/system_wrapper/system/system_fitness_memory_0/s00_couplers_imp_1QRQH4L/system_fitness_memory_imp_auto_pc_0/system_fitness_memory_imp_auto_pc_0_axi_protocol_converter_v2_1_37_axi_protocol_converter/system_fitness_memory_imp_auto_pc_0_axi_protocol_converter_v2_1_37_axi3_conv/system_fitness_memory_imp_auto_pc_0_axi_protocol_converter_v2_1_37_a_axi3_conv/system_fitness_memory_imp_auto_pc_0_axi_data_fifo_v2_1_36_axic_fifo/system_fitness_memory_imp_auto_pc_0_axi_data_fifo_v2_1_36_fifo_gen/<hidden>/<hidden>/<hidden>/<hidden>/<hidden>
                         net (fo=33, routed)          2.121     6.261    qr_desktop_top/system_wrapper/system/system_fitness_memory_0/s00_couplers_imp_1QRQH4L/system_fitness_memory_imp_auto_pc_0/system_fitness_memory_imp_auto_pc_0_axi_protocol_converter_v2_1_37_axi_protocol_converter/system_fitness_memory_imp_auto_pc_0_axi_protocol_converter_v2_1_37_axi3_conv/system_fitness_memory_imp_auto_pc_0_axi_protocol_converter_v2_1_37_a_axi3_conv/system_fitness_memory_imp_auto_pc_0_axi_data_fifo_v2_1_36_axic_fifo/system_fitness_memory_imp_auto_pc_0_axi_data_fifo_v2_1_36_fifo_gen/<hidden>/<hidden>/<hidden>/<hidden>/<hidden>/<hidden>
    SLICE_X27Y103        FDCE                                         f  qr_desktop_top/system_wrapper/system/system_fitness_memory_0/s00_couplers_imp_1QRQH4L/system_fitness_memory_imp_auto_pc_0/system_fitness_memory_imp_auto_pc_0_axi_protocol_converter_v2_1_37_axi_protocol_converter/system_fitness_memory_imp_auto_pc_0_axi_protocol_converter_v2_1_37_axi3_conv/system_fitness_memory_imp_auto_pc_0_axi_protocol_converter_v2_1_37_a_axi3_conv/system_fitness_memory_imp_auto_pc_0_axi_data_fifo_v2_1_36_axic_fifo/system_fitness_memory_imp_auto_pc_0_axi_data_fifo_v2_1_36_fifo_gen/<hidden>/<hidden>/<hidden>/<hidden>/<hidden>/<hidden>
  -------------------------------------------------------------------    -------------------

                         (clock clk_fpga_0 rise edge)
                                                     10.000    10.000 r  
    PS7_X0Y0             PS7                          0.000    10.000 r  system_i/system_i/ps7/inst/PS7_i/FCLKCLK[0]
                         net (fo=1, routed)           0.905    10.906    system_i/system_i/ps7/inst/FCLK_CLK_unbuffered[0]
    BUFGCTRL_X0Y16       BUFG (Prop_bufg_I_O)         0.077    10.983 r  system_i/system_i/ps7/inst/buffer_fclk_clk_0.FCLK_CLK_0_BUFG/O
                         net (fo=28349, routed)       1.427    12.409    qr_desktop_top/system_wrapper/system/system_fitness_memory_0/s00_couplers_imp_1QRQH4L/system_fitness_memory_imp_auto_pc_0/system_fitness_memory_imp_auto_pc_0_axi_protocol_converter_v2_1_37_axi_protocol_converter/system_fitness_memory_imp_auto_pc_0_axi_protocol_converter_v2_1_37_axi3_conv/system_fitness_memory_imp_auto_pc_0_axi_protocol_converter_v2_1_37_a_axi3_conv/system_fitness_memory_imp_auto_pc_0_axi_data_fifo_v2_1_36_axic_fifo/system_fitness_memory_imp_auto_pc_0_axi_data_fifo_v2_1_36_fifo_gen/<hidden>/<hidden>/<hidden>/<hidden>/<hidden>/<hidden>
    SLICE_X27Y103        FDCE                                         r  qr_desktop_top/system_wrapper/system/system_fitness_memory_0/s00_couplers_imp_1QRQH4L/system_fitness_memory_imp_auto_pc_0/system_fitness_memory_imp_auto_pc_0_axi_protocol_converter_v2_1_37_axi_protocol_converter/system_fitness_memory_imp_auto_pc_0_axi_protocol_converter_v2_1_37_axi3_conv/system_fitness_memory_imp_auto_pc_0_axi_protocol_converter_v2_1_37_a_axi3_conv/system_fitness_memory_imp_auto_pc_0_axi_data_fifo_v2_1_36_axic_fifo/system_fitness_memory_imp_auto_pc_0_axi_data_fifo_v2_1_36_fifo_gen/<hidden>/<hidden>/<hidden>/<hidden>/<hidden>/<hidden>
                         clock pessimism              0.240    12.649    
                         clock uncertainty           -0.154    12.495    
    SLICE_X27Y103        FDCE (Recov_fdce_C_CLR)     -0.331    12.164    qr_desktop_top/system_wrapper/system/system_fitness_memory_0/s00_couplers_imp_1QRQH4L/system_fitness_memory_imp_auto_pc_0/system_fitness_memory_imp_auto_pc_0_axi_protocol_converter_v2_1_37_axi_protocol_converter/system_fitness_memory_imp_auto_pc_0_axi_protocol_converter_v2_1_37_axi3_conv/system_fitness_memory_imp_auto_pc_0_axi_protocol_converter_v2_1_37_a_axi3_conv/system_fitness_memory_imp_auto_pc_0_axi_data_fifo_v2_1_36_axic_fifo/system_fitness_memory_imp_auto_pc_0_axi_data_fifo_v2_1_36_fifo_gen/<hidden>/<hidden>/<hidden>/<hidden>/<hidden>/<hidden>
  -------------------------------------------------------------------
                         required time                         12.164    
                         arrival time                          -6.261    
  -------------------------------------------------------------------
                         slack                                  5.903    

Min Delay Paths
--------------------------------------------------------------------------------------
Slack (MET) :             0.598ns  (arrival time - required time)
  Source:                 qr_desktop_top/system_wrapper/system/system_qr_memory_0/s00_couplers_imp_O8NU30/system_qr_memory_imp_auto_pc_0/system_qr_memory_imp_auto_pc_0_axi_protocol_converter_v2_1_37_axi_protocol_converter/system_qr_memory_imp_auto_pc_0_axi_protocol_converter_v2_1_37_axi3_conv/system_qr_memory_imp_auto_pc_0_axi_protocol_converter_v2_1_37_a_axi3_conv/system_qr_memory_imp_auto_pc_0_axi_data_fifo_v2_1_36_axic_fifo/system_qr_memory_imp_auto_pc_0_axi_data_fifo_v2_1_36_fifo_gen_1/<hidden>/<hidden>/<hidden>/<hidden>/<hidden>
                            (rising edge-triggered cell FDRE clocked by clk_fpga_0  {rise@0.000ns fall@5.000ns period=10.000ns})
  Destination:            qr_desktop_top/system_wrapper/system/system_qr_memory_0/s00_couplers_imp_O8NU30/system_qr_memory_imp_auto_pc_0/system_qr_memory_imp_auto_pc_0_axi_protocol_converter_v2_1_37_axi_protocol_converter/system_qr_memory_imp_auto_pc_0_axi_protocol_converter_v2_1_37_axi3_conv/system_qr_memory_imp_auto_pc_0_axi_protocol_converter_v2_1_37_a_axi3_conv/system_qr_memory_imp_auto_pc_0_axi_data_fifo_v2_1_36_axic_fifo/system_qr_memory_imp_auto_pc_0_axi_data_fifo_v2_1_36_fifo_gen_1/<hidden>/<hidden>/<hidden>/<hidden>/<hidden>/<hidden>
                            (removal check against rising-edge clock clk_fpga_0  {rise@0.000ns fall@5.000ns period=10.000ns})
  Path Group:             **async_default**
  Path Type:              Removal (Min at Fast Process Corner)
  Requirement:            0.000ns  (clk_fpga_0 rise@0.000ns - clk_fpga_0 rise@0.000ns)
  Data Path Delay:        0.522ns  (logic 0.186ns (35.633%)  route 0.336ns (64.367%))
  Logic Levels:           1  (LUT3=1)
  Clock Path Skew:        0.016ns (DCD - SCD - CPR)
    Destination Clock Delay (DCD):    1.190ns
    Source Clock Delay      (SCD):    0.893ns
    Clock Pessimism Removal (CPR):    0.281ns

    Location             Delay type                Incr(ns)  Path(ns)    Netlist Resource(s)
  -------------------------------------------------------------------    -------------------
                         (clock clk_fpga_0 rise edge)
                                                      0.000     0.000 r  
    PS7_X0Y0             PS7                          0.000     0.000 r  system_i/system_i/ps7/inst/PS7_i/FCLKCLK[0]
                         net (fo=1, routed)           0.310     0.310    system_i/system_i/ps7/inst/FCLK_CLK_unbuffered[0]
    BUFGCTRL_X0Y16       BUFG (Prop_bufg_I_O)         0.026     0.336 r  system_i/system_i/ps7/inst/buffer_fclk_clk_0.FCLK_CLK_0_BUFG/O
                         net (fo=28349, routed)       0.557     0.893    qr_desktop_top/system_wrapper/system/system_qr_memory_0/s00_couplers_imp_O8NU30/system_qr_memory_imp_auto_pc_0/system_qr_memory_imp_auto_pc_0_axi_protocol_converter_v2_1_37_axi_protocol_converter/system_qr_memory_imp_auto_pc_0_axi_protocol_converter_v2_1_37_axi3_conv/system_qr_memory_imp_auto_pc_0_axi_protocol_converter_v2_1_37_a_axi3_conv/system_qr_memory_imp_auto_pc_0_axi_data_fifo_v2_1_36_axic_fifo/system_qr_memory_imp_auto_pc_0_axi_data_fifo_v2_1_36_fifo_gen_1/<hidden>/<hidden>/<hidden>/<hidden>/<hidden>
    SLICE_X33Y59         FDRE                                         r  qr_desktop_top/system_wrapper/system/system_qr_memory_0/s00_couplers_imp_O8NU30/system_qr_memory_imp_auto_pc_0/system_qr_memory_imp_auto_pc_0_axi_protocol_converter_v2_1_37_axi_protocol_converter/system_qr_memory_imp_auto_pc_0_axi_protocol_converter_v2_1_37_axi3_conv/system_qr_memory_imp_auto_pc_0_axi_protocol_converter_v2_1_37_a_axi3_conv/system_qr_memory_imp_auto_pc_0_axi_data_fifo_v2_1_36_axic_fifo/system_qr_memory_imp_auto_pc_0_axi_data_fifo_v2_1_36_fifo_gen_1/<hidden>/<hidden>/<hidden>/<hidden>/<hidden>
  -------------------------------------------------------------------    -------------------
    SLICE_X33Y59         FDRE (Prop_fdre_C_Q)         0.141     1.034 f  qr_desktop_top/system_wrapper/system/system_qr_memory_0/s00_couplers_imp_O8NU30/system_qr_memory_imp_auto_pc_0/system_qr_memory_imp_auto_pc_0_axi_protocol_converter_v2_1_37_axi_protocol_converter/system_qr_memory_imp_auto_pc_0_axi_protocol_converter_v2_1_37_axi3_conv/system_qr_memory_imp_auto_pc_0_axi_protocol_converter_v2_1_37_a_axi3_conv/system_qr_memory_imp_auto_pc_0_axi_data_fifo_v2_1_36_axic_fifo/system_qr_memory_imp_auto_pc_0_axi_data_fifo_v2_1_36_fifo_gen_1/<hidden>/<hidden>/<hidden>/<hidden>/<hidden>
                         net (fo=3, routed)           0.211     1.245    qr_desktop_top/system_wrapper/system/system_qr_memory_0/s00_couplers_imp_O8NU30/system_qr_memory_imp_auto_pc_0/system_qr_memory_imp_auto_pc_0_axi_protocol_converter_v2_1_37_axi_protocol_converter/system_qr_memory_imp_auto_pc_0_axi_protocol_converter_v2_1_37_axi3_conv/system_qr_memory_imp_auto_pc_0_axi_protocol_converter_v2_1_37_a_axi3_conv/system_qr_memory_imp_auto_pc_0_axi_data_fifo_v2_1_36_axic_fifo/system_qr_memory_imp_auto_pc_0_axi_data_fifo_v2_1_36_fifo_gen_1/<hidden>/<hidden>/<hidden>/<hidden>/<hidden>
    SLICE_X33Y58         LUT3 (Prop_lut3_I1_O)        0.045     1.290 f  qr_desktop_top/system_wrapper/system/system_qr_memory_0/s00_couplers_imp_O8NU30/system_qr_memory_imp_auto_pc_0/system_qr_memory_imp_auto_pc_0_axi_protocol_converter_v2_1_37_axi_protocol_converter/system_qr_memory_imp_auto_pc_0_axi_protocol_converter_v2_1_37_axi3_conv/system_qr_memory_imp_auto_pc_0_axi_protocol_converter_v2_1_37_a_axi3_conv/system_qr_memory_imp_auto_pc_0_axi_data_fifo_v2_1_36_axic_fifo/system_qr_memory_imp_auto_pc_0_axi_data_fifo_v2_1_36_fifo_gen_1/<hidden>/<hidden>/<hidden>/<hidden>/<hidden>
                         net (fo=32, routed)          0.125     1.415    qr_desktop_top/system_wrapper/system/system_qr_memory_0/s00_couplers_imp_O8NU30/system_qr_memory_imp_auto_pc_0/system_qr_memory_imp_auto_pc_0_axi_protocol_converter_v2_1_37_axi_protocol_converter/system_qr_memory_imp_auto_pc_0_axi_protocol_converter_v2_1_37_axi3_conv/system_qr_memory_imp_auto_pc_0_axi_protocol_converter_v2_1_37_a_axi3_conv/system_qr_memory_imp_auto_pc_0_axi_data_fifo_v2_1_36_axic_fifo/system_qr_memory_imp_auto_pc_0_axi_data_fifo_v2_1_36_fifo_gen_1/<hidden>/<hidden>/<hidden>/<hidden>/<hidden>/<hidden>
    SLICE_X33Y57         FDCE                                         f  qr_desktop_top/system_wrapper/system/system_qr_memory_0/s00_couplers_imp_O8NU30/system_qr_memory_imp_auto_pc_0/system_qr_memory_imp_auto_pc_0_axi_protocol_converter_v2_1_37_axi_protocol_converter/system_qr_memory_imp_auto_pc_0_axi_protocol_converter_v2_1_37_axi3_conv/system_qr_memory_imp_auto_pc_0_axi_protocol_converter_v2_1_37_a_axi3_conv/system_qr_memory_imp_auto_pc_0_axi_data_fifo_v2_1_36_axic_fifo/system_qr_memory_imp_auto_pc_0_axi_data_fifo_v2_1_36_fifo_gen_1/<hidden>/<hidden>/<hidden>/<hidden>/<hidden>/<hidden>
  -------------------------------------------------------------------    -------------------

                         (clock clk_fpga_0 rise edge)
                                                      0.000     0.000 r  
    PS7_X0Y0             PS7                          0.000     0.000 r  system_i/system_i/ps7/inst/PS7_i/FCLKCLK[0]
                         net (fo=1, routed)           0.337     0.337    system_i/system_i/ps7/inst/FCLK_CLK_unbuffered[0]
    BUFGCTRL_X0Y16       BUFG (Prop_bufg_I_O)         0.029     0.366 r  system_i/system_i/ps7/inst/buffer_fclk_clk_0.FCLK_CLK_0_BUFG/O
                         net (fo=28349, routed)       0.824     1.190    qr_desktop_top/system_wrapper/system/system_qr_memory_0/s00_couplers_imp_O8NU30/system_qr_memory_imp_auto_pc_0/system_qr_memory_imp_auto_pc_0_axi_protocol_converter_v2_1_37_axi_protocol_converter/system_qr_memory_imp_auto_pc_0_axi_protocol_converter_v2_1_37_axi3_conv/system_qr_memory_imp_auto_pc_0_axi_protocol_converter_v2_1_37_a_axi3_conv/system_qr_memory_imp_auto_pc_0_axi_data_fifo_v2_1_36_axic_fifo/system_qr_memory_imp_auto_pc_0_axi_data_fifo_v2_1_36_fifo_gen_1/<hidden>/<hidden>/<hidden>/<hidden>/<hidden>/<hidden>
    SLICE_X33Y57         FDCE                                         r  qr_desktop_top/system_wrapper/system/system_qr_memory_0/s00_couplers_imp_O8NU30/system_qr_memory_imp_auto_pc_0/system_qr_memory_imp_auto_pc_0_axi_protocol_converter_v2_1_37_axi_protocol_converter/system_qr_memory_imp_auto_pc_0_axi_protocol_converter_v2_1_37_axi3_conv/system_qr_memory_imp_auto_pc_0_axi_protocol_converter_v2_1_37_a_axi3_conv/system_qr_memory_imp_auto_pc_0_axi_data_fifo_v2_1_36_axic_fifo/system_qr_memory_imp_auto_pc_0_axi_data_fifo_v2_1_36_fifo_gen_1/<hidden>/<hidden>/<hidden>/<hidden>/<hidden>/<hidden>
                         clock pessimism             -0.281     0.909    
    SLICE_X33Y57         FDCE (Remov_fdce_C_CLR)     -0.092     0.817    qr_desktop_top/system_wrapper/system/system_qr_memory_0/s00_couplers_imp_O8NU30/system_qr_memory_imp_auto_pc_0/system_qr_memory_imp_auto_pc_0_axi_protocol_converter_v2_1_37_axi_protocol_converter/system_qr_memory_imp_auto_pc_0_axi_protocol_converter_v2_1_37_axi3_conv/system_qr_memory_imp_auto_pc_0_axi_protocol_converter_v2_1_37_a_axi3_conv/system_qr_memory_imp_auto_pc_0_axi_data_fifo_v2_1_36_axic_fifo/system_qr_memory_imp_auto_pc_0_axi_data_fifo_v2_1_36_fifo_gen_1/<hidden>/<hidden>/<hidden>/<hidden>/<hidden>/<hidden>
  -------------------------------------------------------------------
                         required time                         -0.817    
                         arrival time                           1.415    
  -------------------------------------------------------------------
                         slack                                  0.598
