Lone-Jade/ZYNQ7020-QR_Code_Recogition/skill/result-association-and-publication/references/provenance.md

# Scope and verification limits

Result identity, geometry association, publication queues, committed state and visible output acknowledgement in concurrent pipelines.

Function calls and accepted queue entries are distinct from transport delivery and physical display. Validate actual identity, capacity, restart and stale-state behavior.

Use the checks appropriate to the requested change and report which were actually executed. Package contents are reusable procedures and helpers; they do not certify a new environment or target.
