Lone-Jade/ZYNQ7020-QR_Code_Recogition/skill/systematic-debugging/references/provenance.md

# Scope and verification limits

Evidence-based diagnosis, localization of the first failing boundary, discriminating experiments and focused repair.

A plausible explanation remains a hypothesis until the relevant observation supports it. Source review and successful builds do not qualify runtime or physical behavior.

Use the checks appropriate to the requested change and report which were actually executed. Package contents are reusable procedures and helpers; they do not certify a new environment or target.
