Lone-Jade/ZYNQ7020-QR_Code_Recogition/src/hardware/pynq_ax7021b/hardware/desktop/hdmi.xdc

## AX7021B SIL9134 HDMI output (UG table 3-4-1)
set_property IOSTANDARD LVCMOS33 [get_ports hdmi_clk]
set_property PACKAGE_PIN G16 [get_ports hdmi_clk]
set_property IOSTANDARD LVCMOS33 [get_ports hdmi_hs]
set_property PACKAGE_PIN E19 [get_ports hdmi_hs]
set_property IOSTANDARD LVCMOS33 [get_ports hdmi_vs]
set_property PACKAGE_PIN F16 [get_ports hdmi_vs]
set_property IOSTANDARD LVCMOS33 [get_ports hdmi_de]
set_property PACKAGE_PIN E20 [get_ports hdmi_de]
set_property IOSTANDARD LVCMOS33 [get_ports hdmi_reset_n]
set_property PACKAGE_PIN C17 [get_ports hdmi_reset_n]
set_property IOSTANDARD LVCMOS33 [get_ports hdmi_iic_scl_io]
set_property PACKAGE_PIN B22 [get_ports hdmi_iic_scl_io]
set_property IOSTANDARD LVCMOS33 [get_ports hdmi_iic_sda_io]
set_property PACKAGE_PIN A22 [get_ports hdmi_iic_sda_io]
set_property PULLUP true [get_ports hdmi_iic_scl_io]
set_property PULLUP true [get_ports hdmi_iic_sda_io]
set_property IOSTANDARD LVCMOS33 [get_ports {hdmi_d[0]}]
set_property PACKAGE_PIN H22 [get_ports {hdmi_d[0]}]
set_property IOSTANDARD LVCMOS33 [get_ports {hdmi_d[1]}]
set_property PACKAGE_PIN G22 [get_ports {hdmi_d[1]}]
set_property IOSTANDARD LVCMOS33 [get_ports {hdmi_d[2]}]
set_property PACKAGE_PIN G17 [get_ports {hdmi_d[2]}]
set_property IOSTANDARD LVCMOS33 [get_ports {hdmi_d[3]}]
set_property PACKAGE_PIN F17 [get_ports {hdmi_d[3]}]
set_property IOSTANDARD LVCMOS33 [get_ports {hdmi_d[4]}]
set_property PACKAGE_PIN G15 [get_ports {hdmi_d[4]}]
set_property IOSTANDARD LVCMOS33 [get_ports {hdmi_d[5]}]
set_property PACKAGE_PIN D15 [get_ports {hdmi_d[5]}]
set_property IOSTANDARD LVCMOS33 [get_ports {hdmi_d[6]}]
set_property PACKAGE_PIN E15 [get_ports {hdmi_d[6]}]
set_property IOSTANDARD LVCMOS33 [get_ports {hdmi_d[7]}]
set_property PACKAGE_PIN F18 [get_ports {hdmi_d[7]}]
set_property IOSTANDARD LVCMOS33 [get_ports {hdmi_d[8]}]
set_property PACKAGE_PIN E18 [get_ports {hdmi_d[8]}]
set_property IOSTANDARD LVCMOS33 [get_ports {hdmi_d[9]}]
set_property PACKAGE_PIN H17 [get_ports {hdmi_d[9]}]
set_property IOSTANDARD LVCMOS33 [get_ports {hdmi_d[10]}]
set_property PACKAGE_PIN H18 [get_ports {hdmi_d[10]}]
set_property IOSTANDARD LVCMOS33 [get_ports {hdmi_d[11]}]
set_property PACKAGE_PIN H19 [get_ports {hdmi_d[11]}]
set_property IOSTANDARD LVCMOS33 [get_ports {hdmi_d[12]}]
set_property PACKAGE_PIN H20 [get_ports {hdmi_d[12]}]
set_property IOSTANDARD LVCMOS33 [get_ports {hdmi_d[13]}]
set_property PACKAGE_PIN G19 [get_ports {hdmi_d[13]}]
set_property IOSTANDARD LVCMOS33 [get_ports {hdmi_d[14]}]
set_property PACKAGE_PIN F19 [get_ports {hdmi_d[14]}]
set_property IOSTANDARD LVCMOS33 [get_ports {hdmi_d[15]}]
set_property PACKAGE_PIN G20 [get_ports {hdmi_d[15]}]
set_property IOSTANDARD LVCMOS33 [get_ports {hdmi_d[16]}]
set_property PACKAGE_PIN G21 [get_ports {hdmi_d[16]}]
set_property IOSTANDARD LVCMOS33 [get_ports {hdmi_d[17]}]
set_property PACKAGE_PIN F21 [get_ports {hdmi_d[17]}]
set_property IOSTANDARD LVCMOS33 [get_ports {hdmi_d[18]}]
set_property PACKAGE_PIN F22 [get_ports {hdmi_d[18]}]
set_property IOSTANDARD LVCMOS33 [get_ports {hdmi_d[19]}]
set_property PACKAGE_PIN E21 [get_ports {hdmi_d[19]}]
set_property IOSTANDARD LVCMOS33 [get_ports {hdmi_d[20]}]
set_property PACKAGE_PIN D21 [get_ports {hdmi_d[20]}]
set_property IOSTANDARD LVCMOS33 [get_ports {hdmi_d[21]}]
set_property PACKAGE_PIN D22 [get_ports {hdmi_d[21]}]
set_property IOSTANDARD LVCMOS33 [get_ports {hdmi_d[22]}]
set_property PACKAGE_PIN C22 [get_ports {hdmi_d[22]}]
set_property IOSTANDARD LVCMOS33 [get_ports {hdmi_d[23]}]
set_property PACKAGE_PIN B21 [get_ports {hdmi_d[23]}]
set_property SLEW FAST [get_ports {hdmi_d[*]}]
set_property DRIVE 8 [get_ports {hdmi_d[*]}]
set_property SLEW FAST [get_ports {hdmi_clk hdmi_hs hdmi_vs hdmi_de}]

# ODDR inverts the pixel clock: output rising edge is the sampling edge.
# Conservative board-level setup/hold budget; both checks must pass.
create_generated_clock -name hdmi_forwarded -source [get_pins -hier -filter {NAME =~ */clock_out/C}] -divide_by 1 -invert [get_ports hdmi_clk]
set_output_delay -clock hdmi_forwarded -max 2.0 [get_ports {hdmi_d[*] hdmi_de hdmi_hs hdmi_vs}]
set_output_delay -clock hdmi_forwarded -min -0.5 [get_ports {hdmi_d[*] hdmi_de hdmi_hs hdmi_vs}]
