Lone-Jade/ZYNQ7020-QR_Code_Recogition/src/hardware/pynq_ax7021b/hardware/desktop/pwm_led.xdc

## AX7021B PL-connected user LEDs. Both LEDs are active-low.
set_property IOSTANDARD LVCMOS33 [get_ports {pwm_led_n[0]}]
set_property PACKAGE_PIN R7 [get_ports {pwm_led_n[0]}]
set_property IOSTANDARD LVCMOS33 [get_ports {pwm_led_n[1]}]
set_property PACKAGE_PIN A16 [get_ports {pwm_led_n[1]}]
