Lone-Jade/ZYNQ7020-QR_Code_Recogition/src/software/imported/camera/ov5640_config.h

#ifndef OV5640_CONFIG_H
#define OV5640_CONFIG_H

#include "xil_types.h"
#include "ethernet_config.h"

typedef struct {
    u16 reg;
    u8 value;
} Ov5640Reg;

#define OV5640_REG_DELAY 0xfffeU
#define OV5640_REG_END   0xffffU

/* ---- 帧率档位（详见 THROUGHPUT_PROBE.md）-----------------------------------
 * 帧率 = PCLK / (HTS x VTS)。原表 HTS=1896、VTS=984、实测 30.0 fps
 *   => PCLK = 1896 * 984 * 30.0 = **56.0 MHz**（不是从 0x4837 估的 58.8）。
 * 抬 PLL 就是按比例抬 PCLK，实测与模型吻合到 1% 以内。
 *
 * fps 的算法：先量网卡线速，再除以**每帧线上字节数 8.072 Mbit**（960000 负载
 * + 700*24 包头 + 700*46 的 UDP/IP/以太网开销）。别用仅负载的 7.68 Mbit/帧，
 * 那会把帧率报高约 5%。档位 8 另有直接点名计数：575 帧 / 11.94 s = 48.1 fps。
 *
 * **全部档位已上板实测（2026-10-02）**：
 *
 *   档位 0 = 原表 HTS=1896 VTS=984 PLL=0x46   -> 30.0 fps ✅（原基线）
 *   档位 1 = HTS=1600                          -> ❌ 无帧
 *   档位 2 = HTS=1400                          -> ❌ 无帧
 *   档位 3 = HTS=1200                          -> ❌ 无帧
 *   档位 4 = VTS=768                           -> ❌ 无帧
 *   档位 5 = HTS=1600 + VTS=900                -> ❌ 无帧
 *   档位 6 = PLL 0x3036=0x54 (PCLK ≈ 67.2MHz)  -> 36 fps ✅
 *   档位 7 = PLL 0x3036=0x60 (PCLK ≈ 76.8MHz)  -> 41 fps ✅ 画面正常
 *   档位 8 = PLL 0x3036=0x70 (PCLK ≈ 89.6MHz)  -> **48 fps** ✅ 默认（实测 48.1）
 *   档位 9 = PLL 0x3036=0x80 (PCLK ≈102.4MHz)  -> **55 fps** ✅ 画面正常 = 实测上限
 *   档位 10= PLL 0x3036=0xa0                   -> 44 fps ↓（不升反降）
 *   档位 11= PLL 0x3036=0xb0                   -> 38 fps ↓
 *
 * **两条结论**
 *   1. 提帧率要抬 PLL（PCLK），**不要动 HTS/VTS** —— 档位 1~5 全部让传感器彻底不出图
 *      （camera_init 成功、无 VDMA halt、但 VDMA 一个帧缓冲都没被写）。
 *      追加写和就地改值两种写法都试过，结果相同，所以不是"重复写寄存器"引起的。
 *   2. 抬 PLL 的效果与 `fps = PCLK/(HTS*VTS)` 吻合到 1% 以内，**一直到档位 9 为止**；
 *      再往上（10/11）帧率反而下降 —— 传感器 DVP 在 PCLK ≈ 100 MHz 左右到顶。
 *
 * 代价：PCLK 越高，同一曝光行数对应的曝光时间越短（图更暗、AEC 靠增益补偿），
 * 但运动模糊更小 —— 对运动的二维码是有利的。档位 8 的线上码率 ≈ 391 Mbit/s，
 * 实测链路能到 817 Mbit/s，余量充足。
 *
 * 注意 PCLK 一变，**0x4837（PCLK 周期提示值）必须跟着改**，否则 DVP 时序不匹配。
 * 位流里 `create_clock cam1_pclk -period 10.000`（100 MHz）——档位 8（89.6MHz）在其内；
 * 档位 9（102.4MHz）略超出，实测硬件上是通的，但长期用应改约束并重跑实现。
 *
 * **分辨率**：本板 800x600 可用；1024x576(HD) 与 640x480 **实测采不到帧**——
 * 2026-10-02 用 ov5640_1 自己的 HD 位流+应用做 A/B，S2MM SR 恒为 0、无帧完成，
 * 与本工程表现一致。换分辨率必须整表下发（PLL + 输出尺寸 + 裁剪窗口 +
 * 0x3814/0x3815 + HTS/VTS + 0x4837 一起），并上板验证。
 *
 * 这些寄存器**必须写在 stream-on(0x3008=0x02) 之前**：实测流启动后再写，
 * AXI IIC 的 XIic_Send 会返回 0/1（失败），继续访问还会把应用卡死。 */
/* 帧率档位由视频档位（ethernet_config.h 的 VIDEO_PROFILE）决定，
 * 也可用 -DOV5640_FAST_TIMING=n 单独特调（做实验时用）。
 * 档位必须与 VIDEO_WIDTH/HEIGHT 属于同一份传感器表，否则几何会错。 */
#ifndef OV5640_FAST_TIMING
#if VIDEO_PROFILE == VIDEO_PROFILE_800x600_48FPS
#define OV5640_FAST_TIMING 8      /* PCLK 89.6 MHz，HTS 1896 / VTS 984 -> 48.0 fps */
#elif VIDEO_PROFILE == VIDEO_PROFILE_1280x720_30FPS
#define OV5640_FAST_TIMING 12     /* 1280x720@30fps 专用档（见下表 HD 分支） */
#else
#error "VIDEO_PROFILE 没有对应的 OV5640_FAST_TIMING 档位"
#endif
#endif

/*
 * AN5642 官方 OV5640 公共初始化；模块自带参考时钟，AX7021B J16 只控制
 * RESETB 和 SCCB。The module supplies the sensor reference clock
 * locally; only RESETB and SCCB are controlled by the AX7021B J16 interface.
 *
 * AN5642 official OV5640 公共初始化（两个档位共用），后面接一段**随
 * VIDEO_PROFILE 切换**的几何/时序覆盖块（见本文件末尾的 #if 段）。
 *
 * 800x600 那一段来自 ov5640_1 的 workspace_2025_svga —— 在 AX7021B 实板上
 * **实测画面正常**的那一版。此前的 1024x576 表（0x3036=0x54）和 640x480 表
 * 在本板上都采不到帧。
 * 1280x720 那一段是推导出来的（HTS=3200/VTS=800/0x3036=0x60，恰好 30.000 fps），
 * 依赖的约束与验算过程都写在那个分支的注释里。
 */
static const Ov5640Reg g_ov5640_rgb565[] = {
    {0x3103, 0x11}, {0x3008, 0x82}, {OV5640_REG_DELAY, 10},
    {0x3008, 0x42}, {0x3103, 0x03}, {0x3017, 0xff}, {0x3018, 0xff},
    {0x3034, 0x1a}, {0x3037, 0x13}, {0x3108, 0x01},
    {0x3630, 0x36}, {0x3631, 0x0e}, {0x3632, 0xe2}, {0x3633, 0x12},
    {0x3621, 0xe0}, {0x3704, 0xa0}, {0x3703, 0x5a}, {0x3715, 0x78},
    {0x3717, 0x01}, {0x370b, 0x60}, {0x3705, 0x1a}, {0x3905, 0x02},
    {0x3906, 0x10}, {0x3901, 0x0a}, {0x3731, 0x12}, {0x3600, 0x08},
    {0x3601, 0x33}, {0x302d, 0x60}, {0x3620, 0x52}, {0x371b, 0x20},
    {0x471c, 0x50}, {0x3a13, 0x43}, {0x3a18, 0x00}, {0x3a19, 0xf8},
    {0x3635, 0x13}, {0x3636, 0x03}, {0x3634, 0x40}, {0x3622, 0x01},
    {0x3c01, 0x34}, {0x3c04, 0x28}, {0x3c05, 0x98}, {0x3c06, 0x00},
    {0x3c07, 0x08}, {0x3c08, 0x00}, {0x3c09, 0x1c}, {0x3c0a, 0x9c},
    {0x3c0b, 0x40}, {0x3810, 0x00}, {0x3811, 0x10}, {0x3812, 0x00},
    {0x3708, 0x64}, {0x4001, 0x02}, {0x4005, 0x1a}, {0x3000, 0x00},
    {0x3004, 0xff}, {0x300e, 0x58}, {0x302e, 0x00}, {0x4300, 0x60},
    {0x501f, 0x01}, {0x440e, 0x00}, {0x5000, 0xa7},
    {0x3a0f, 0x30}, {0x3a10, 0x28}, {0x3a1b, 0x30}, {0x3a1e, 0x26},
    {0x3a11, 0x60}, {0x3a1f, 0x14},

    /* Lens correction. */
    {0x5800, 0x23}, {0x5801, 0x14}, {0x5802, 0x0f}, {0x5803, 0x0f},
    {0x5804, 0x12}, {0x5805, 0x26}, {0x5806, 0x0c}, {0x5807, 0x08},
    {0x5808, 0x05}, {0x5809, 0x05}, {0x580a, 0x08}, {0x580b, 0x0d},
    {0x580c, 0x08}, {0x580d, 0x03}, {0x580e, 0x00}, {0x580f, 0x00},
    {0x5810, 0x03}, {0x5811, 0x09}, {0x5812, 0x07}, {0x5813, 0x03},
    {0x5814, 0x00}, {0x5815, 0x01}, {0x5816, 0x03}, {0x5817, 0x08},
    {0x5818, 0x0d}, {0x5819, 0x08}, {0x581a, 0x05}, {0x581b, 0x06},
    {0x581c, 0x08}, {0x581d, 0x0e}, {0x581e, 0x29}, {0x581f, 0x17},
    {0x5820, 0x11}, {0x5821, 0x11}, {0x5822, 0x15}, {0x5823, 0x28},
    {0x5824, 0x46}, {0x5825, 0x26}, {0x5826, 0x08}, {0x5827, 0x26},
    {0x5828, 0x64}, {0x5829, 0x26}, {0x582a, 0x24}, {0x582b, 0x22},
    {0x582c, 0x24}, {0x582d, 0x24}, {0x582e, 0x06}, {0x582f, 0x22},
    {0x5830, 0x40}, {0x5831, 0x42}, {0x5832, 0x24}, {0x5833, 0x26},
    {0x5834, 0x24}, {0x5835, 0x22}, {0x5836, 0x22}, {0x5837, 0x26},
    {0x5838, 0x44}, {0x5839, 0x24}, {0x583a, 0x26}, {0x583b, 0x28},
    {0x583c, 0x42}, {0x583d, 0xce},

    /* Automatic white balance. */
    {0x5180, 0xff}, {0x5181, 0xf2}, {0x5182, 0x00}, {0x5183, 0x14},
    {0x5184, 0x25}, {0x5185, 0x24}, {0x5186, 0x09}, {0x5187, 0x09},
    {0x5188, 0x09}, {0x5189, 0x75}, {0x518a, 0x54}, {0x518b, 0xe0},
    {0x518c, 0xb2}, {0x518d, 0x42}, {0x518e, 0x3d}, {0x518f, 0x56},
    {0x5190, 0x46}, {0x5191, 0xf8}, {0x5192, 0x04}, {0x5193, 0x70},
    {0x5194, 0xf0}, {0x5195, 0xf0}, {0x5196, 0x03}, {0x5197, 0x01},
    {0x5198, 0x04}, {0x5199, 0x12}, {0x519a, 0x04}, {0x519b, 0x00},
    {0x519c, 0x06}, {0x519d, 0x82}, {0x519e, 0x38},

    /* Gamma, colour matrix and sharpening. */
    {0x5480, 0x01}, {0x5481, 0x08}, {0x5482, 0x14}, {0x5483, 0x28},
    {0x5484, 0x51}, {0x5485, 0x65}, {0x5486, 0x71}, {0x5487, 0x7d},
    {0x5488, 0x87}, {0x5489, 0x91}, {0x548a, 0x9a}, {0x548b, 0xaa},
    {0x548c, 0xb8}, {0x548d, 0xcd}, {0x548e, 0xdd}, {0x548f, 0xea},
    {0x5490, 0x1d}, {0x5381, 0x1e}, {0x5382, 0x5b}, {0x5383, 0x08},
    {0x5384, 0x0a}, {0x5385, 0x7e}, {0x5386, 0x88}, {0x5387, 0x7c},
    {0x5388, 0x6c}, {0x5389, 0x10}, {0x538a, 0x01}, {0x538b, 0x98},
    {0x5580, 0x06}, {0x5583, 0x40}, {0x5584, 0x10}, {0x5589, 0x10},
    {0x558a, 0x00}, {0x558b, 0xf8}, {0x501d, 0x40},
    {0x5300, 0x08}, {0x5301, 0x30}, {0x5302, 0x10}, {0x5303, 0x00},
    {0x5304, 0x08}, {0x5305, 0x30}, {0x5306, 0x08}, {0x5307, 0x16},
    {0x5309, 0x08}, {0x530a, 0x30}, {0x530b, 0x04}, {0x530c, 0x06},
    {0x5025, 0x00},

    /* ================= 档位相关：几何 + 行/帧时序 ==========================
     * 这一段**随 VIDEO_PROFILE 切换**，其余（AN5642 公共初始化）两个档位共用。
     * 整段必须在 stream-on(0x3008=0x02) 之前下发。
     * ==================================================================== */
#if VIDEO_PROFILE == VIDEO_PROFILE_800x600_48FPS
    /* 800x600, RGB565, DVP. Preserve the validated PLL and line timing. */
    {0x3035, 0x11},
#if OV5640_FAST_TIMING == 6
    {0x3036, 0x54},                    /* PLL ×1.20 -> PCLK ≈ 67.2 MHz  -> 36 fps */
#elif OV5640_FAST_TIMING == 7
    {0x3036, 0x60},                    /* PLL ×1.37 -> PCLK ≈ 76.8 MHz  -> 41 fps */
#elif OV5640_FAST_TIMING == 8
    {0x3036, 0x70},                    /* PLL ×1.60 -> PCLK ≈ 89.6 MHz  -> 48 fps（实测 48.1） */
#elif OV5640_FAST_TIMING == 9
    {0x3036, 0x80},                    /* PLL ×1.83 -> PCLK ≈102.4 MHz  -> 55 fps（实测上限） */
#elif OV5640_FAST_TIMING == 10
    {0x3036, 0xa0},                    /* PLL ×2.29 -> PCLK ≈128 MHz    -> 实测只有 44 fps（传感器到顶） */
#elif OV5640_FAST_TIMING == 11
    {0x3036, 0xb0},                    /* PLL ×2.51 -> PCLK ≈141 MHz    -> 实测只有 38 fps */
#else
    {0x3036, 0x46},
#endif
    {0x3c07, 0x08},
    /* 180 度旋转：在原来验证过的 0x41/0x07 基础上，把两个轴上的
     * 传感器/ISP 翻转位（bit 2:1）都取反。 */
    {0x3820, 0x47}, {0x3821, 0x01}, {0x3814, 0x31}, {0x3815, 0x31},
    {0x3800, 0x00}, {0x3801, 0x00}, {0x3802, 0x00}, {0x3803, 0x04},
    {0x3804, 0x0a}, {0x3805, 0x3f}, {0x3806, 0x07}, {0x3807, 0x9b},
    {0x3808, 0x03}, {0x3809, 0x20}, {0x380a, 0x02}, {0x380b, 0x58},
    /* HTS=0x0768=1896、VTS=0x03d8=984。**别动这两个旋钮**：实测改 HTS/VTS
     * （5 种改法，含就地改值）都会让传感器一帧都不出，提帧率要靠上面的 0x3036。 */
    {0x380c, 0x07}, {0x380d, 0x68}, {0x380e, 0x03}, {0x380f, 0xd8},
    {0x3813, 0x06}, {0x3618, 0x00}, {0x3612, 0x29}, {0x3709, 0x52},
    {0x370c, 0x03}, {0x3a02, 0x03}, {0x3a03, 0xd8}, {0x3a14, 0x03},
    {0x3a15, 0xd8}, {0x4004, 0x02}, {0x3002, 0x1c}, {0x3006, 0xc3},
    {0x4713, 0x03}, {0x4407, 0x04}, {0x460b, 0x35}, {0x460c, 0x22},
#if OV5640_FAST_TIMING == 6
    {0x4837, 0x1c},                    /* 配 PCLK 67.2 MHz */
#elif OV5640_FAST_TIMING == 7
    {0x4837, 0x19},                    /* 配 PCLK 76.8 MHz */
#elif OV5640_FAST_TIMING == 8
    {0x4837, 0x15},                    /* 配 PCLK 89.6 MHz */
#elif OV5640_FAST_TIMING == 9
    {0x4837, 0x13},                    /* 配 PCLK 102.4 MHz */
#elif OV5640_FAST_TIMING == 10
    {0x4837, 0x0f},                    /* 配 PCLK 128 MHz */
#elif OV5640_FAST_TIMING == 11
    {0x4837, 0x0e},                    /* 配 PCLK 141 MHz */
#else
    {0x4837, 0x22},
#endif

#elif VIDEO_PROFILE == VIDEO_PROFILE_1280x720_30FPS
    /* ---- 1280x720 RGB565 @30fps ------------------------------------------
     * fps = PCLK / (HTS x VTS) = 76.8MHz / (3200 x 800) = 30.000 fps（误差 0%）
     * PCLK = 0.800 x 0x3036 MHz（0x3035=0x11 分支）；VCO = 24 x 96 / 3 = 768 MHz
     *        （在数据手册 800 MHz 上限之内）。
     *
     * **关键约束**：DVP 是 8bit 端口、每个 PCLK 只出一个字节，所以 1280 像素
     * RGB565 的有效行占 2 x 1280 = 2560 个字节时钟，HTS 必须大于它并留出消隐。
     * 这正是 800x600 档位那组实测的由来：有效行 800x2=1600，HTS=1600/1400/1200
     * 全部"不出帧"，1896 才正常（1896/1600 = 1.185）。按同样 ~18% 余量，
     * 1280 宽的 HTS 下限约 3034 → 取 3200（+25%）。
     *
     * 2,560,000 = 2^12 x 5^4，在 [2560,4000] 区间里能同时满足
     * "HTS>2560" 和 "VTS>=744" 的整数解只有 (3200, 800)；再选 76.8 MHz
     * 是因为它是本板已验证过的 0x3036=0x60（原档位 7，41fps 画面正常）。
     * → (HTS=3200, VTS=800) 在 76.8 MHz 下是**唯一合法解**。
     *
     * 0x3034=0x1a / 0x3037=0x13 / 0x3108=0x01 由公共初始化写入，保持不变。
     * 若实测"ID 正常但一帧都不出"：先试 0x3824 由 0x02 改 0x04，
     * 再试 0x460c 由 0x22 改 0x20（PCLK auto）。 */
    {0x3035, 0x11},                    /* SysDiv=1: PCLK = 0.800*0x3036 MHz      */
    {0x3036, 0x60},                    /* PLL -> PCLK 76.8 MHz, VCO 768 MHz       */
    {0x3c07, 0x08},
    {0x3820, 0x47}, {0x3821, 0x01},    /* 180 度旋转，与 800x600 档位一致          */
    {0x3814, 0x31}, {0x3815, 0x31},    /* 与 OmniVision 官方 720p 块相同           */
    {0x3800, 0x00}, {0x3801, 0x00},    /* HS = 0                                   */
    {0x3802, 0x00}, {0x3803, 0xfa},    /* VS = 250（16:9 裁剪起点）                */
    {0x3804, 0x0a}, {0x3805, 0x3f},    /* HE = 2623                                */
    {0x3806, 0x06}, {0x3807, 0xa9},    /* VE = 1705                                */
    {0x3808, 0x05}, {0x3809, 0x00},    /* DVPHO = 1280                             */
    {0x380a, 0x02}, {0x380b, 0xd0},    /* DVPVO = 720                              */
    {0x380c, 0x0c}, {0x380d, 0x80},    /* HTS = 3200                               */
    {0x380e, 0x03}, {0x380f, 0x20},    /* VTS = 800                                */
    {0x3813, 0x04},                    /* VOFFS = 4                                */
    {0x3618, 0x00}, {0x3612, 0x29}, {0x3709, 0x52},
    {0x370c, 0x03},
    {0x3a02, 0x03}, {0x3a03, 0x20},    /* 60Hz 最大曝光 = VTS = 800                */
    {0x3a14, 0x03}, {0x3a15, 0x20},    /* 50Hz 最大曝光 = VTS = 800                */
    {0x4004, 0x02}, {0x3002, 0x1c}, {0x3006, 0xc3},
    {0x4713, 0x03}, {0x4407, 0x04}, {0x460b, 0x35}, {0x460c, 0x22},
    {0x4837, 0x19},                    /* 配 PCLK 76.8 MHz（与档位 7 同值）        */

#else
#error "VIDEO_PROFILE 没有对应的 OV5640 几何/时序块"
#endif
    {0x3824, 0x02}, {0x5001, 0xa3}, {0x3503, 0x00},
    {0x4300, 0x60}, {0x501f, 0x01},
    {0x3008, 0x02},
    {OV5640_REG_DELAY, 20}, {OV5640_REG_END, 0x00}
};

#endif
