Lone-Jade/ZYNQ7020-QR_Code_Recogition/(commit log)

2026-11-01 release: retain reproducible QR sources and externalize pinned platform dependencies
    Source baseline: d57d272c7ea841812e960de689b3d99bf5a61673
    Full original repository backed up locally before splitting.
    [rules.tsv]
2026-11-02 feat: 添加 MIT 许可证和更新项目文档
2026-11-02 docs: rewrite reproducible setup, build and board usage guide
2026-11-03 add physical data
    [data_dictionary.csv, final_5000_by_speed.csv, final_5000_by_speed_k.csv, final_5000_groups.csv, final_5000_targets.csv, measurement_notes.csv, missed_targets.csv, paired_1000_comparison.csv]
2026-11-04 Organize test CSV data and anonymize submission metadata
    [by_speed.csv, by_speed_k.csv, comparison.csv, data_dictionary.csv, decode_events.csv, fields.csv, file_mapping.csv, final_5000_by_speed.csv]
